JoelNymark/modu-hardware/PDFS/4x4pad/Back.png

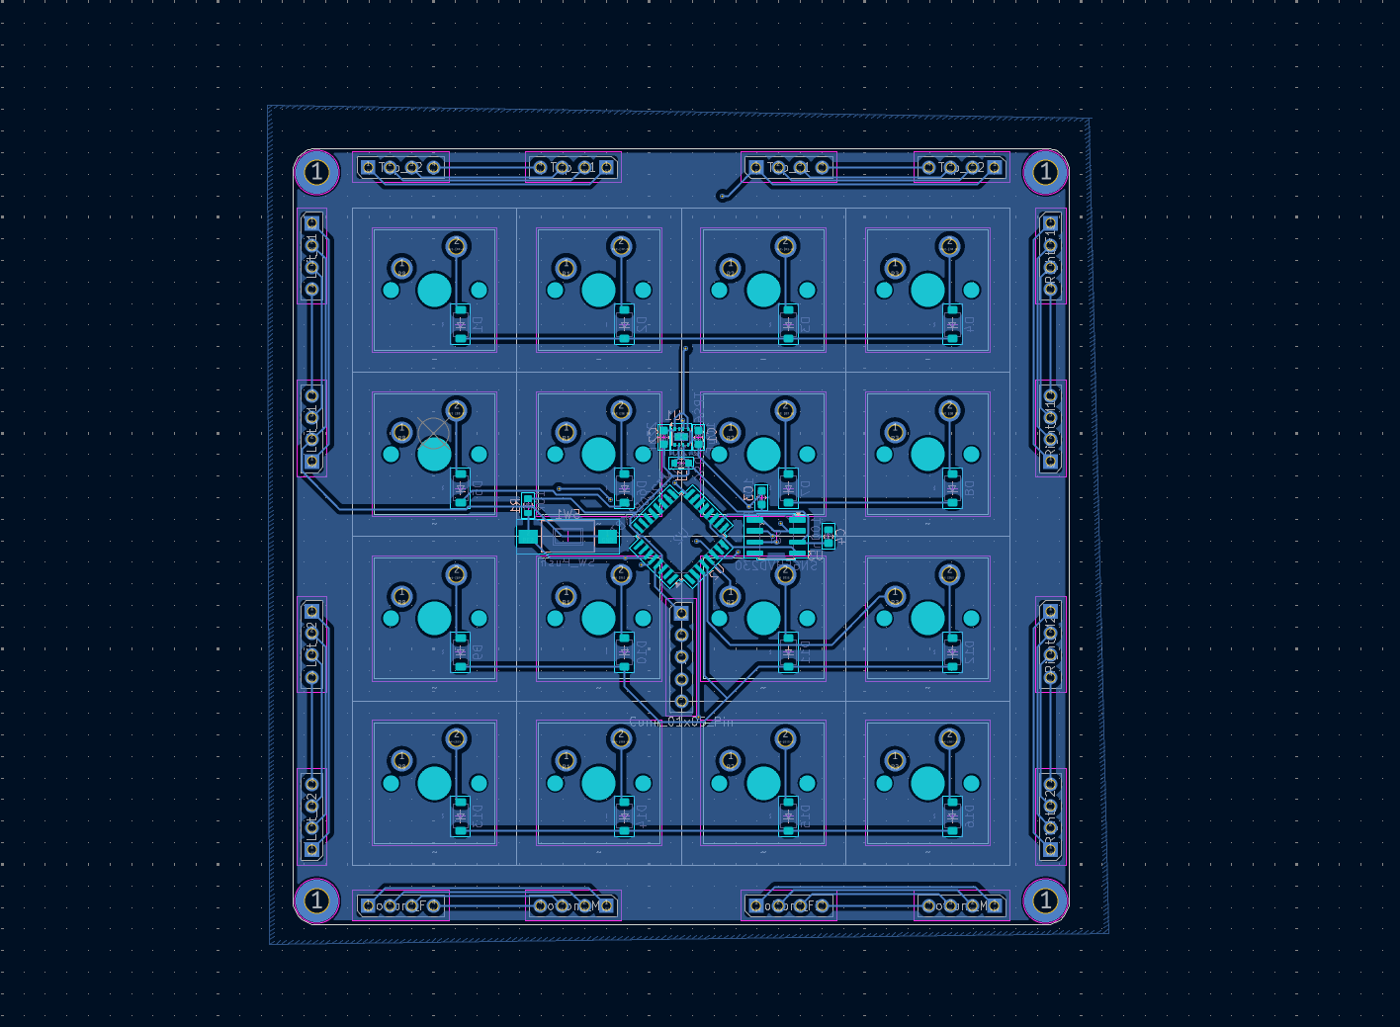
PDFS/4x4pad/Back.png
