JoelNymark/modu-hardware/PDFS/4x4pad/Front.png

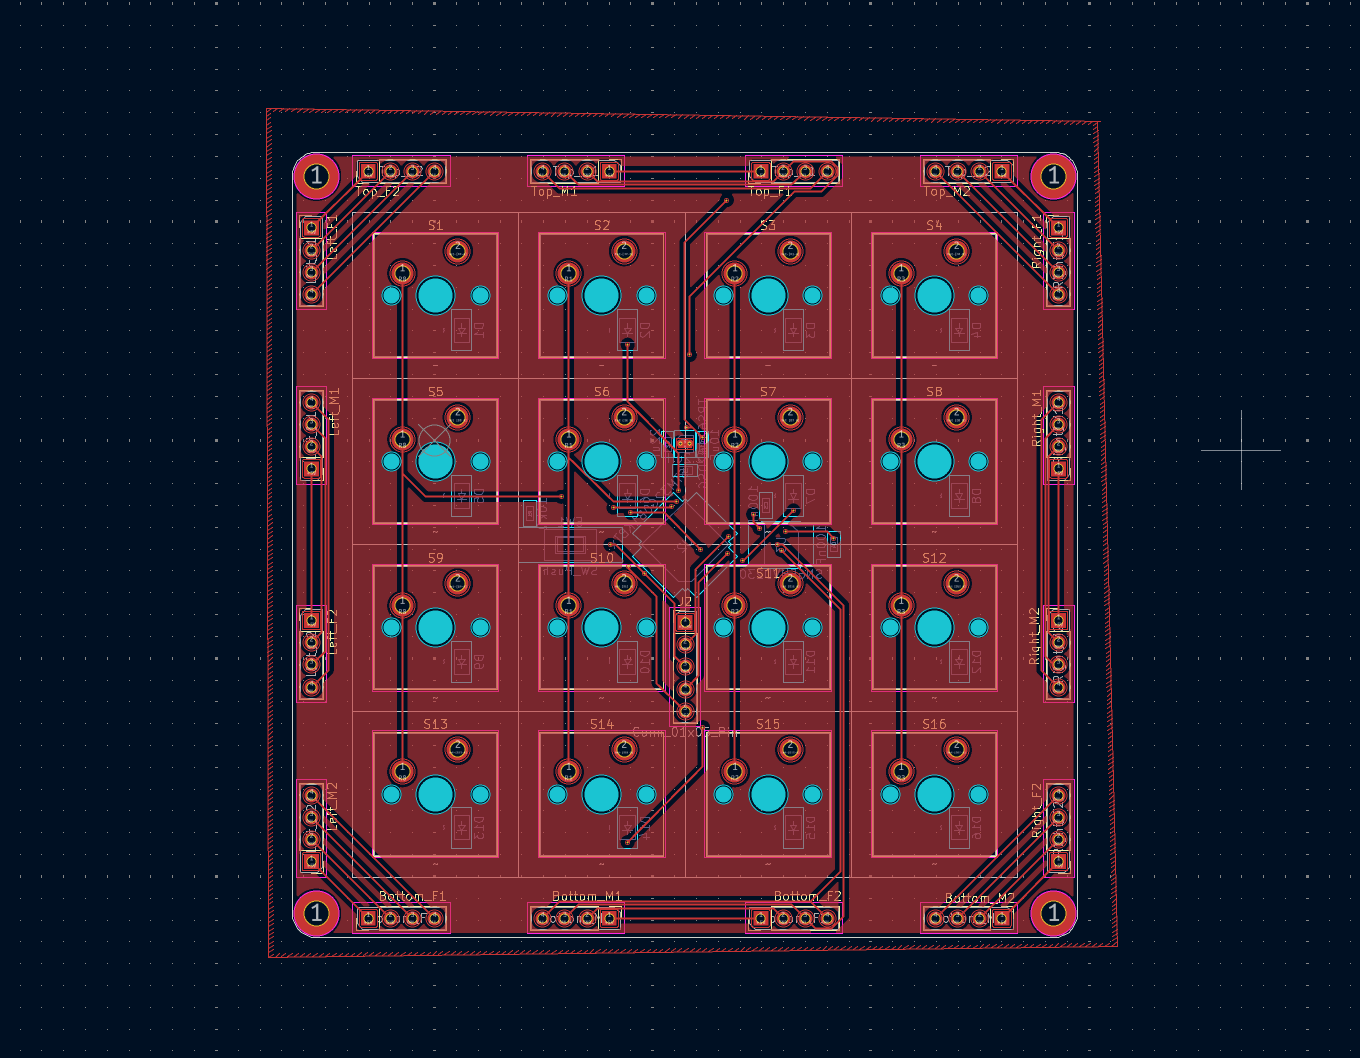
PDFS/4x4pad/Front.png
