JoelNymark/modu-hardware/PDFS/4x4pad/Screenshot 2026-10-29 231250.png

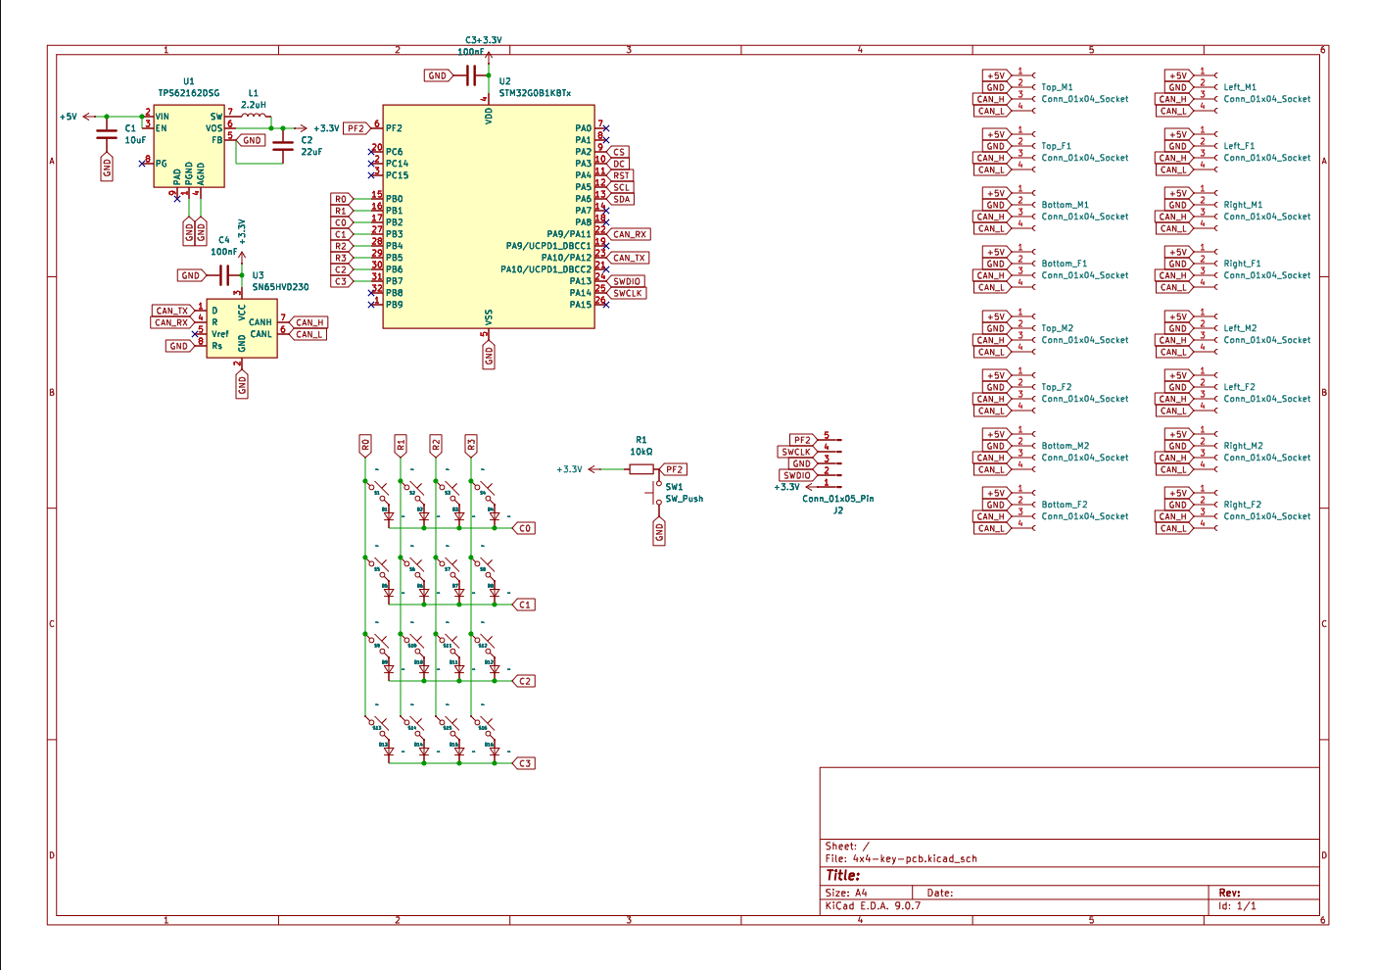
PDFS/4x4pad/Screenshot 2026-10-29 231250.png
