JoelNymark/modu-hardware/PDFS/Hub/Back.png

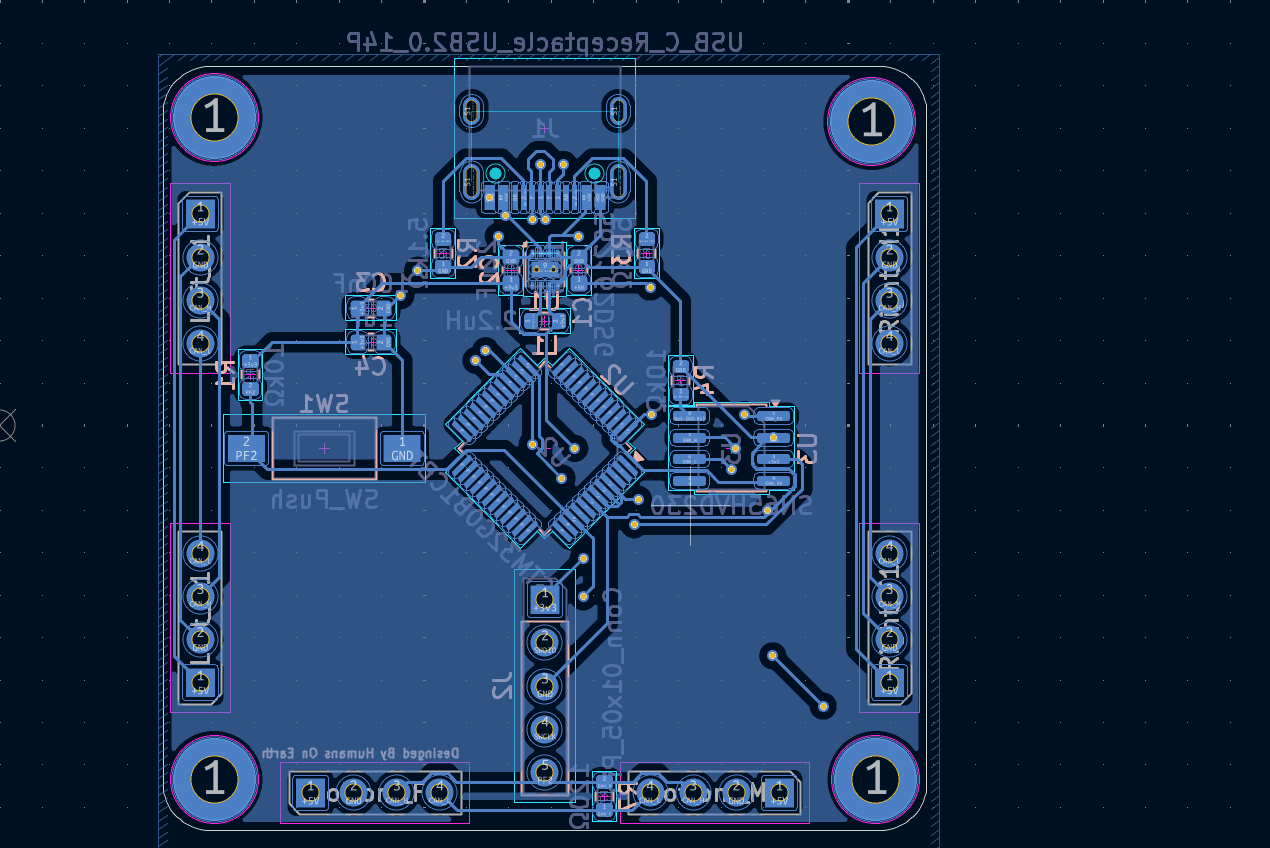
PDFS/Hub/Back.png
