JoelNymark/modu-hardware/PDFS/Hub/Front.png

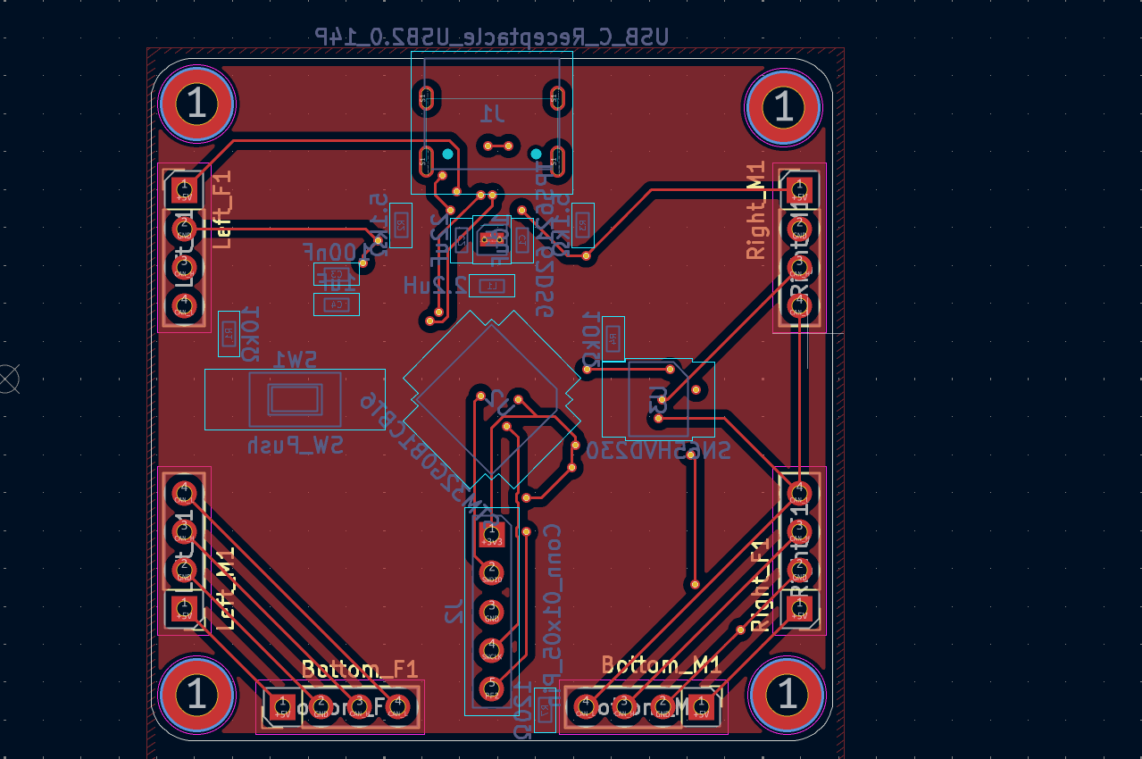
PDFS/Hub/Front.png
