JoelNymark/modu-hardware/PDFS/Hub/Screenshot 2026-10-29 224733.png

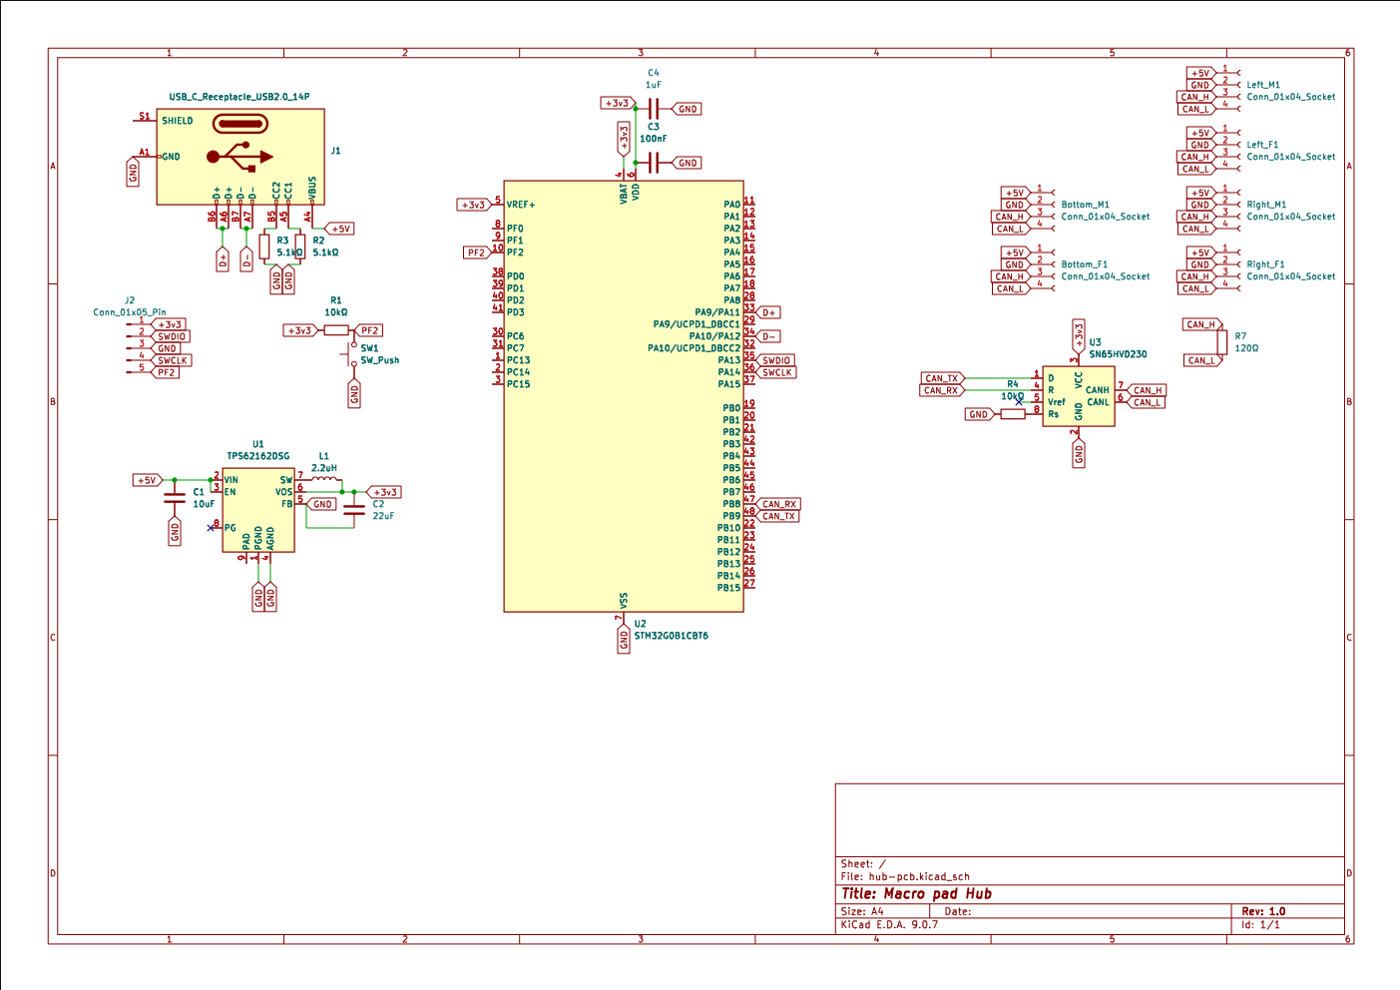
PDFS/Hub/Screenshot 2026-10-29 224733.png
