JoelNymark/modu-hardware/PDFS/Screen Module/Back.png

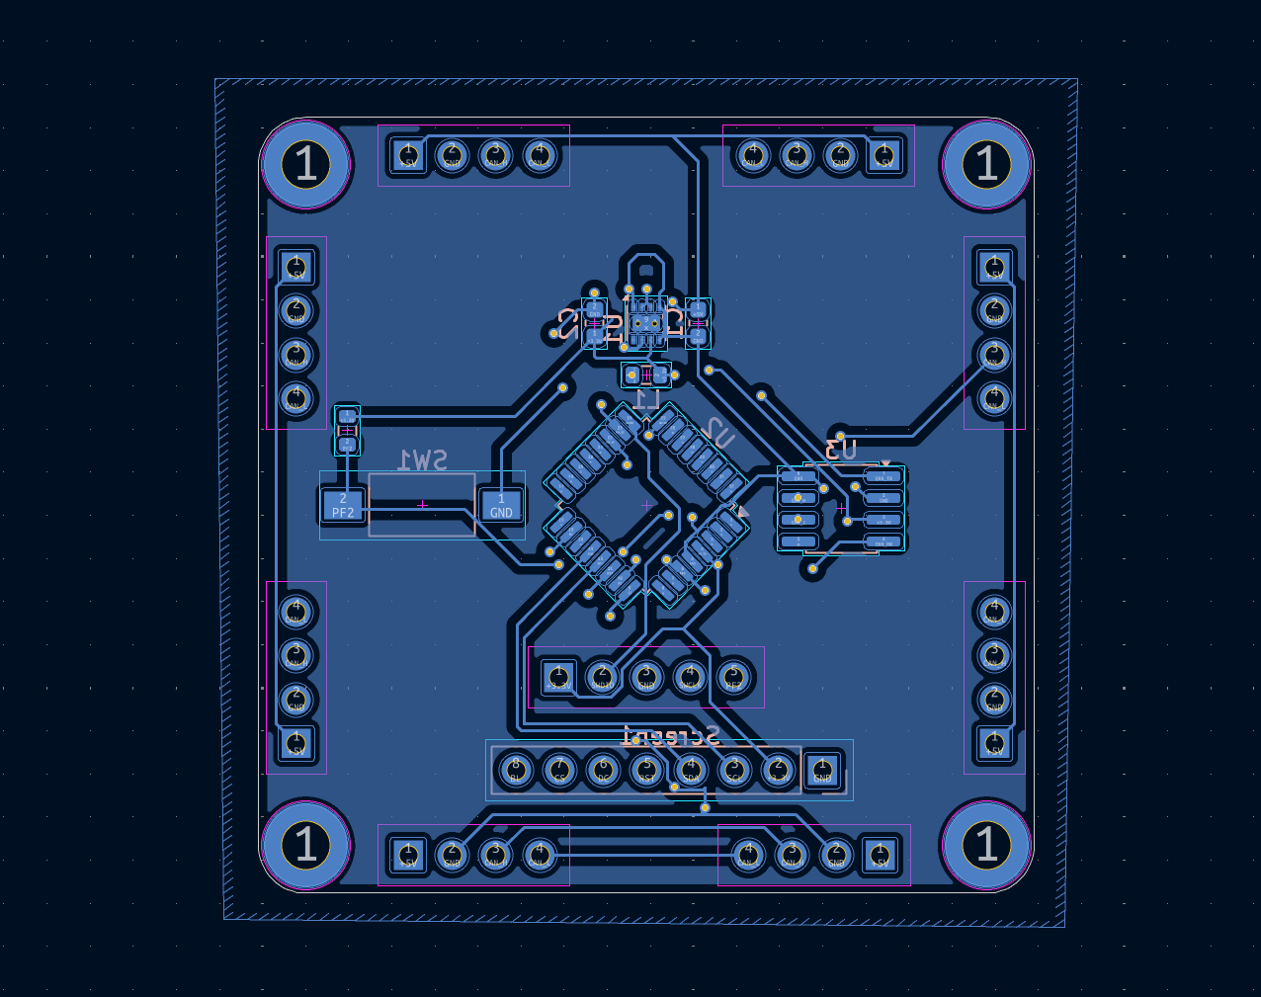
PDFS/Screen Module/Back.png
