JoelNymark/modu-hardware/PDFS/Screen Module/Front.png

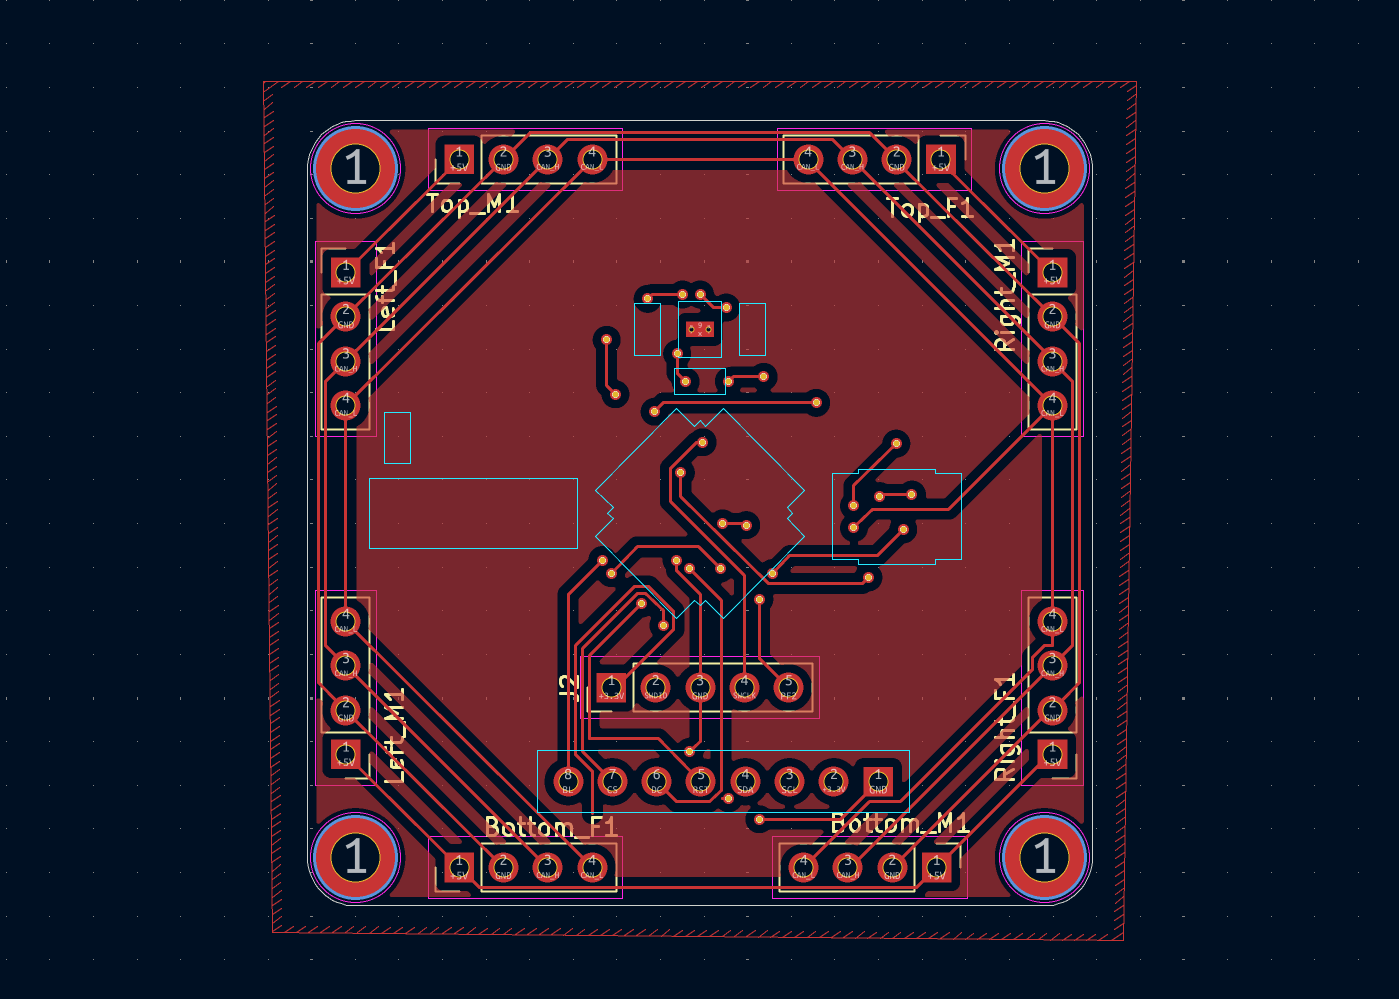
PDFS/Screen Module/Front.png
