JoelNymark/modu-hardware/PDFS/Screen Module/Screenshot 2026-10-29 230948.png

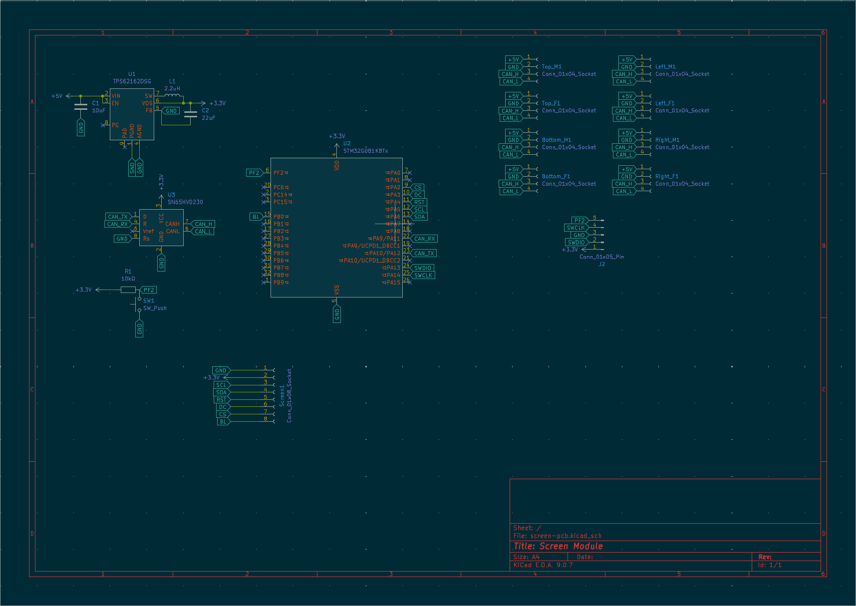
PDFS/Screen Module/Screenshot 2026-10-29 230948.png
