JoelNymark/modu-hardware/PDFS/Screen Module/Screenshot 2026-10-29 231049.png

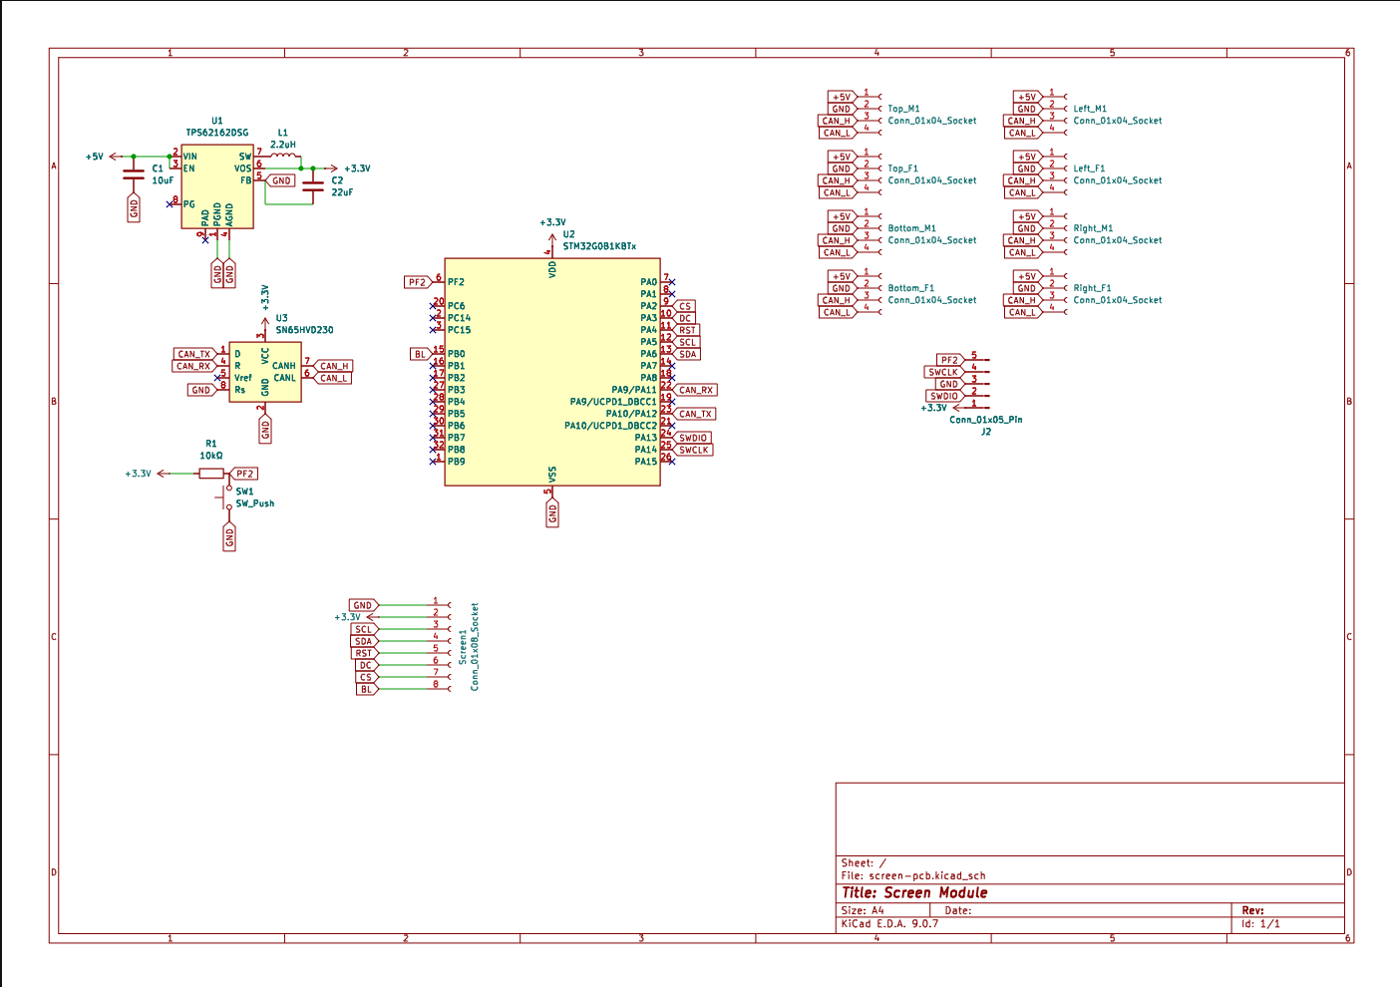
PDFS/Screen Module/Screenshot 2026-10-29 231049.png
