JoelNymark/modu-hardware/hub-pcb/production/bom.csv

Designator | Footprint | Quantity | Value | LCSC Part #
C1 | 0603 | 1 | 10uF
C2 | 0603 | 1 | 22uF
C3, C5, C6 | 0603 | 3 | 100nF
C4 | 0603 | 1 | 1uF
D1 | 2114 | 1 | D_Schottky
D2 | D_SOD-323 | 1 | D_Zener
D3, D4 | D_SOD-323 | 2 | D_TVS
J1 | USB_C_HRO_TYPE-C-31-M-12 | 1 | USB_C_Receptacle_USB2.0_14P
J2, J3, J4, J5, J6, J7 | PinHeader_1x04_P2.54mm_Vertical | 6 | Conn_01x04_Socket
J8 | PinHeader_1x05_P2.54mm_Vertical | 1 | Conn_01x05_Pin
J9 | PinHeader_1x08_P2.54mm_Vertical | 1 | Conn_01x08_Pin
L1 | 0603 | 1 | 2.2uH
R1, R4 | 0603 | 2 | 10kΩ
R2, R3 | 0603 | 2 | 5.1kΩ
R7 | 0603 | 1 | 120Ω
SW1 | SW_PUSH_1P1T_6x3.5mm_H4.3_APEM_MJTP1243 | 1 | SW_Push
U1 | WSON-8-1EP_2x2mm_P0.5mm_EP0.9x1.6mm_ThermalVias | 1 | TPS62162DSG
U2 | LQFP-48_7x7mm_P0.5mm | 1 | STM32G0B1CBT6
U3 | SOIC-8_3.9x4.9mm_P1.27mm | 1 | SN65HVD230
U4 | SOT-23-6 | 1 | USBLC6-2SC6
