JoelNymark/modu-hardware/4x4-key-pcb/production/bom.csv

Designator | Footprint | Quantity | Value | LCSC Part #
BOTTOM_F1, BOTTOM_F2, BOTTOM_M1, BOTTOM_M2, LEFT_F1, LEFT_F2, LEFT_M1, LEFT_M2, RIGHT_F1, RIGHT_F2, RIGHT_M1, RIGHT_M2, TOP_F1, TOP_F2, TOP_M1, TOP_M2 | PinHeader_1x04_P2.54mm_Vertical | 16 | Conn_01x04_Socket
C1 | 0603 | 1 | 10uF
C2 | 0603 | 1 | 22uF
C3, C4 | 0603 | 2 | 100nF
D1, D10, D11, D12, D13, D14, D15, D16, D2, D3, D4, D5, D6, D7, D8, D9 | Diode_SOD-123 | 16 | ~
J2 | PinHeader_1x05_P2.54mm_Vertical | 1 | Conn_01x05_Pin
L1 | 0603 | 1 | 2.2uH
R1 | 0603 | 1 | 10kΩ
S1, S10, S11, S12, S13, S14, S15, S16, S2, S3, S4, S5, S6, S7, S8, S9 | MX_PCB_1.00u | 16 | ~
SW1 | SW_SPST_FSMSM | 1 | SW_Push
U1 | WSON-8-1EP_2x2mm_P0.5mm_EP0.9x1.6mm_ThermalVias | 1 | TPS62162DSG
U2 | LQFP-32_7x7mm_P0.8mm | 1 | STM32G0B1KBTx
U3 | SOIC-8_3.9x4.9mm_P1.27mm | 1 | SN65HVD230
