JoelNymark/modu-hardware/hub-pcb/production/New folder/bom.csv

Designator | Footprint | Quantity | Value | LCSC Part #
BOTTOM_F1, BOTTOM_M1, LEFT_F1, LEFT_M1, RIGHT_F1, RIGHT_M1 | PinHeader_1x04_P2.54mm_Vertical | 6 | Conn_01x04_Socket
C1 | 0603 | 1 | 10uF
C2 | 0603 | 1 | 22uF
C3 | 0603 | 1 | 100nF
C4 | 0603 | 1 | 1uF
J1 | USB_C_HRO_TYPE-C-31-M-12 | 1 | USB_C_Receptacle_USB2.0_14P
J2 | PinHeader_1x05_P2.54mm_Vertical | 1 | Conn_01x05_Pin
L1 | 0603 | 1 | 2.2uH
R1, R4 | 0603 | 2 | 10kΩ
R2, R3 | 0603 | 2 | 5.1kΩ
R7 | 0603 | 1 | 120Ω
SW1 | SW_SPST_FSMSM | 1 | SW_Push
U1 | WSON-8-1EP_2x2mm_P0.5mm_EP0.9x1.6mm_ThermalVias | 1 | TPS62162DSG
U2 | LQFP-48_7x7mm_P0.5mm | 1 | STM32G0B1CBT6
U3 | SOIC-8_3.9x4.9mm_P1.27mm | 1 | SN65HVD230
