JoelNymark/modu-hardware/4x4-key-pcb/4x4-key-pcb.stl

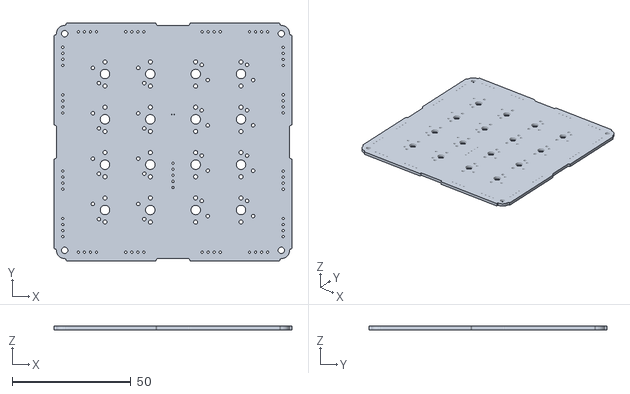
[picture p16: CAD file, 2026-11-02]
4x4-key-pcb/4x4-key-pcb.stl
100.0 x 100.0 x 1.51
