JoelNymark/modu-hardware/hub-pcb/hub-pcb.step

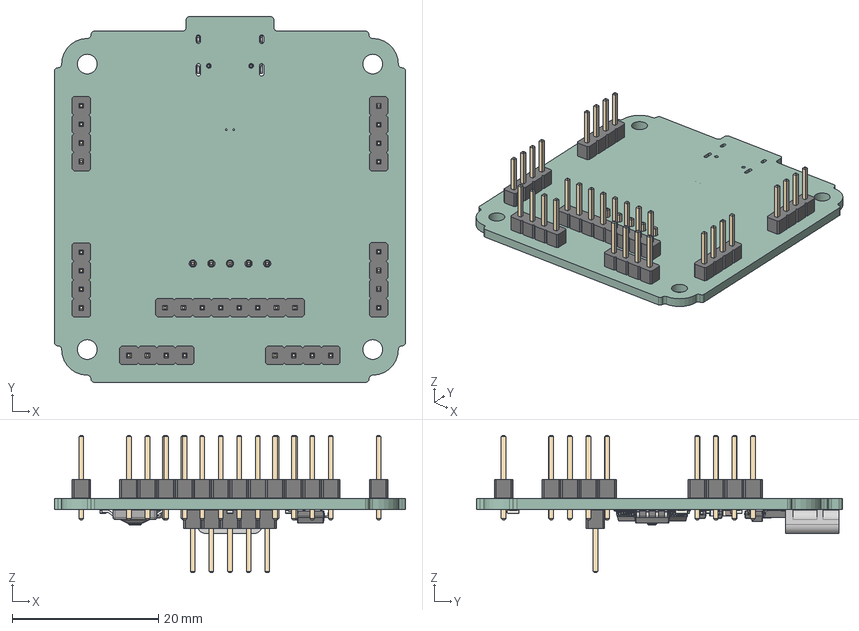
[picture p17: CAD file, 2026-11-02]
hub-pcb/hub-pcb.step
48.0 x 50.0 x 18.8 mm
PinHeader_1x04_P254mm_Vertical x 6
PinHeader_1x08_P254mm_Vertical
D_2114
C_0603_1608Metric x 6
SOIC-8_3.9x4.9mm_P1.27mm
R_0603_1608Metric x 6
WSON_8_1EP_2x2mm_P05mm_EP09x16mm
D_SOD-323 x 3
SOT-23-6
LQFP-48_7x7mm_P0.5mm
pines
cuerpo
boton
PinHeader_1x05_P254mm_Vertical
HRO TYPE-C-31-M-12 v4
hub330C_PCB
