JoelNymark/modu-hardware/hub-pcb/hub-pcb-nocomps.stl

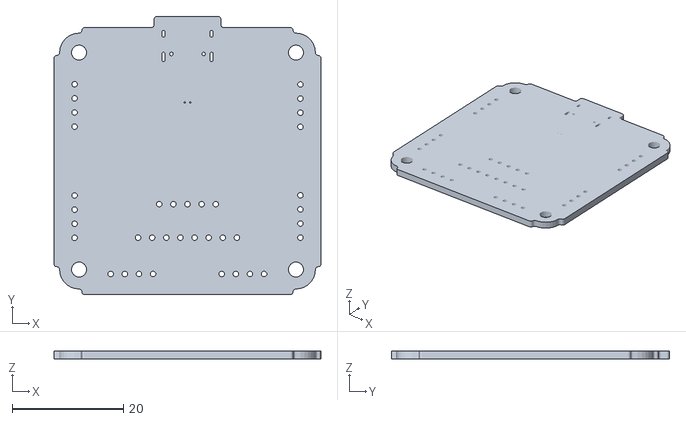
[picture p18: CAD file, 2026-11-02]
hub-pcb/hub-pcb-nocomps.stl
48.0 x 50.0 x 1.51
