JoelNymark/modu-hardware/(list of files, cad)

Other CAD files:
hub-pcb/hub-pcb.stl
