JoelNymark/modu-hardware/hub-pcb/plots/hub-pcb__Assembly.pdf

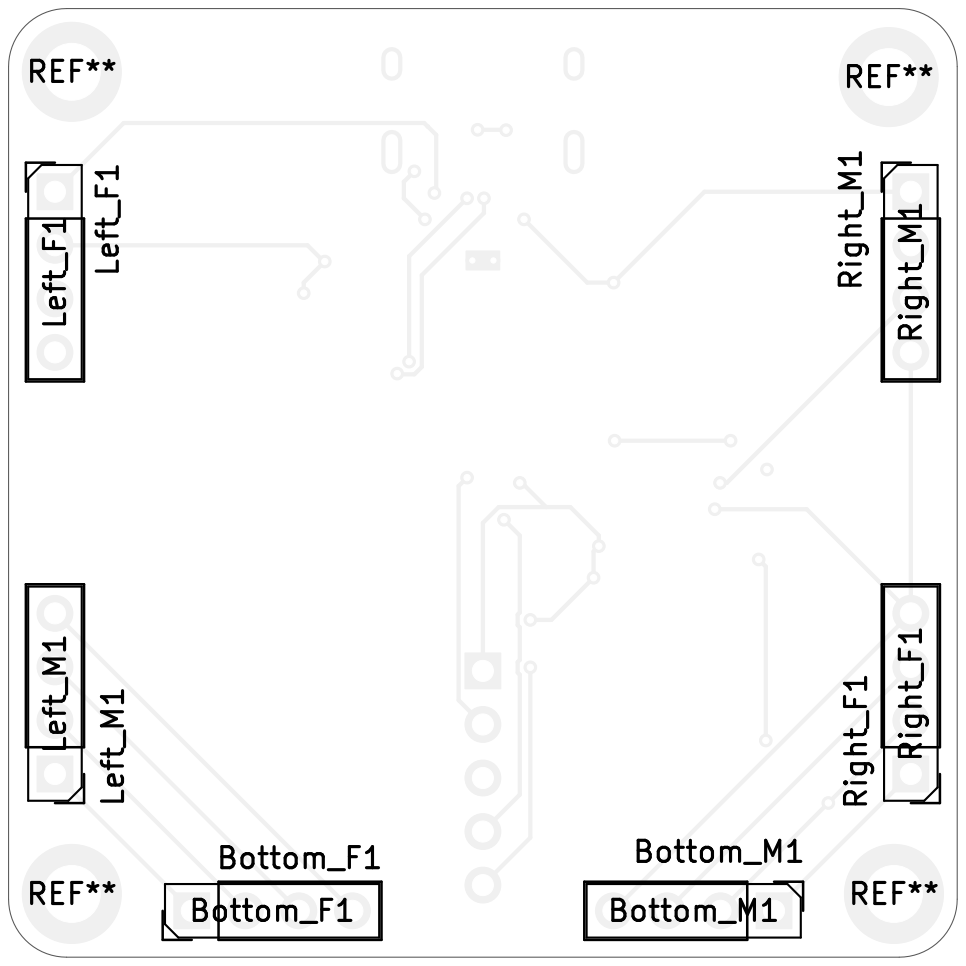
[picture p19: page 1]
Left_M1 Bottom_M1 Left_F1 Bottom_F1 Right_M1 Right_F1 1 2 3 4 5 6; D Date: KiCad; E.D.A. 9.0.7 Size: A4; Rev:; Id: /1 Title: File: hub-pcb.kicad_pcb Sheet: Black; And; White; TOP; Board2Pdf:; Black; TOP -; Page; REF** REF** Left_M¹ REF**; REF** Bottom_M1 Left_F1; Bottom_F1; Right_M¹ Right_F1

C3 Conn_01x05_Pin | J2 þÿ120© R7 | þÿ5.1k© R2

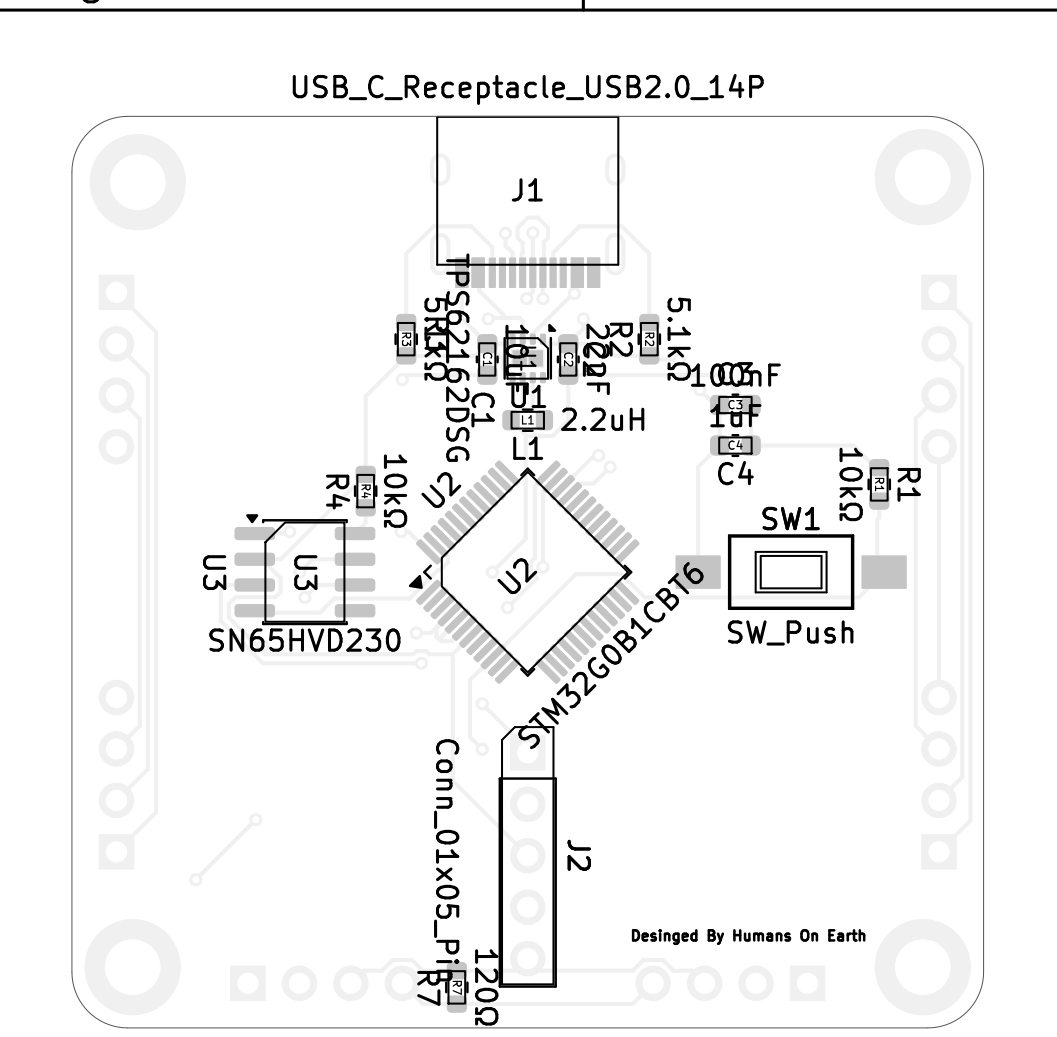
[picture p20: page 2]
