JoelNymark/modu-hardware/PDFS/4x4pad/4x4-key-pcb.pdf

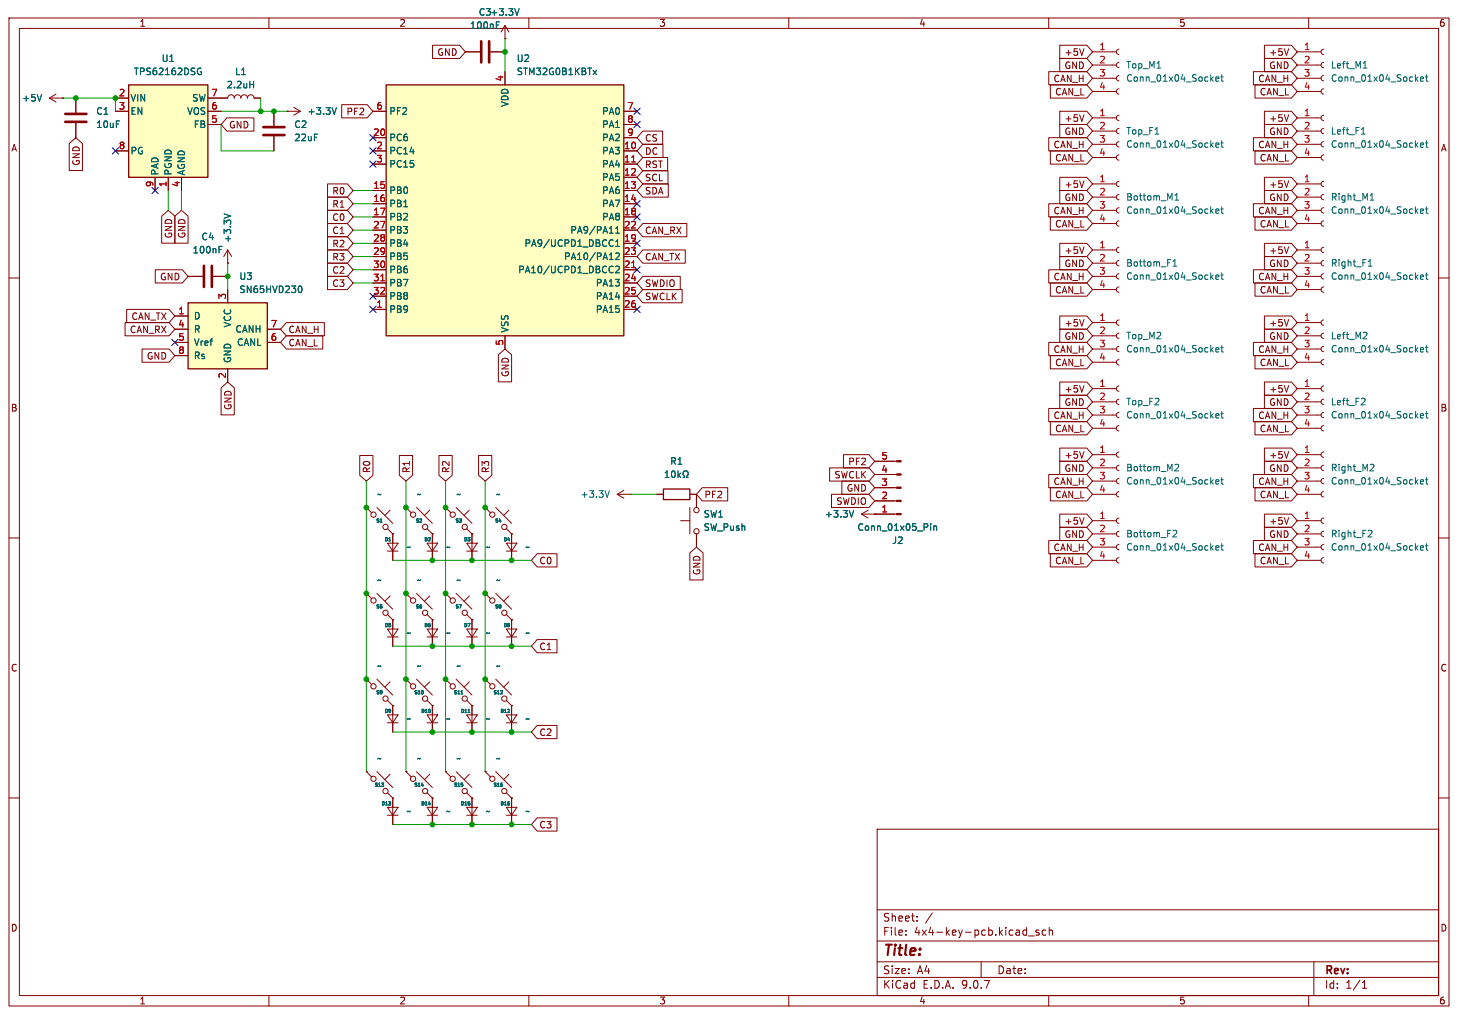
[picture p21: page 1]

Id: 1/1 Title: File: 4x4-key-pcb.kicad_sch Sheet: /
