JoelNymark/modu-hardware/PDFS/Hub/hub-pcb.pdf

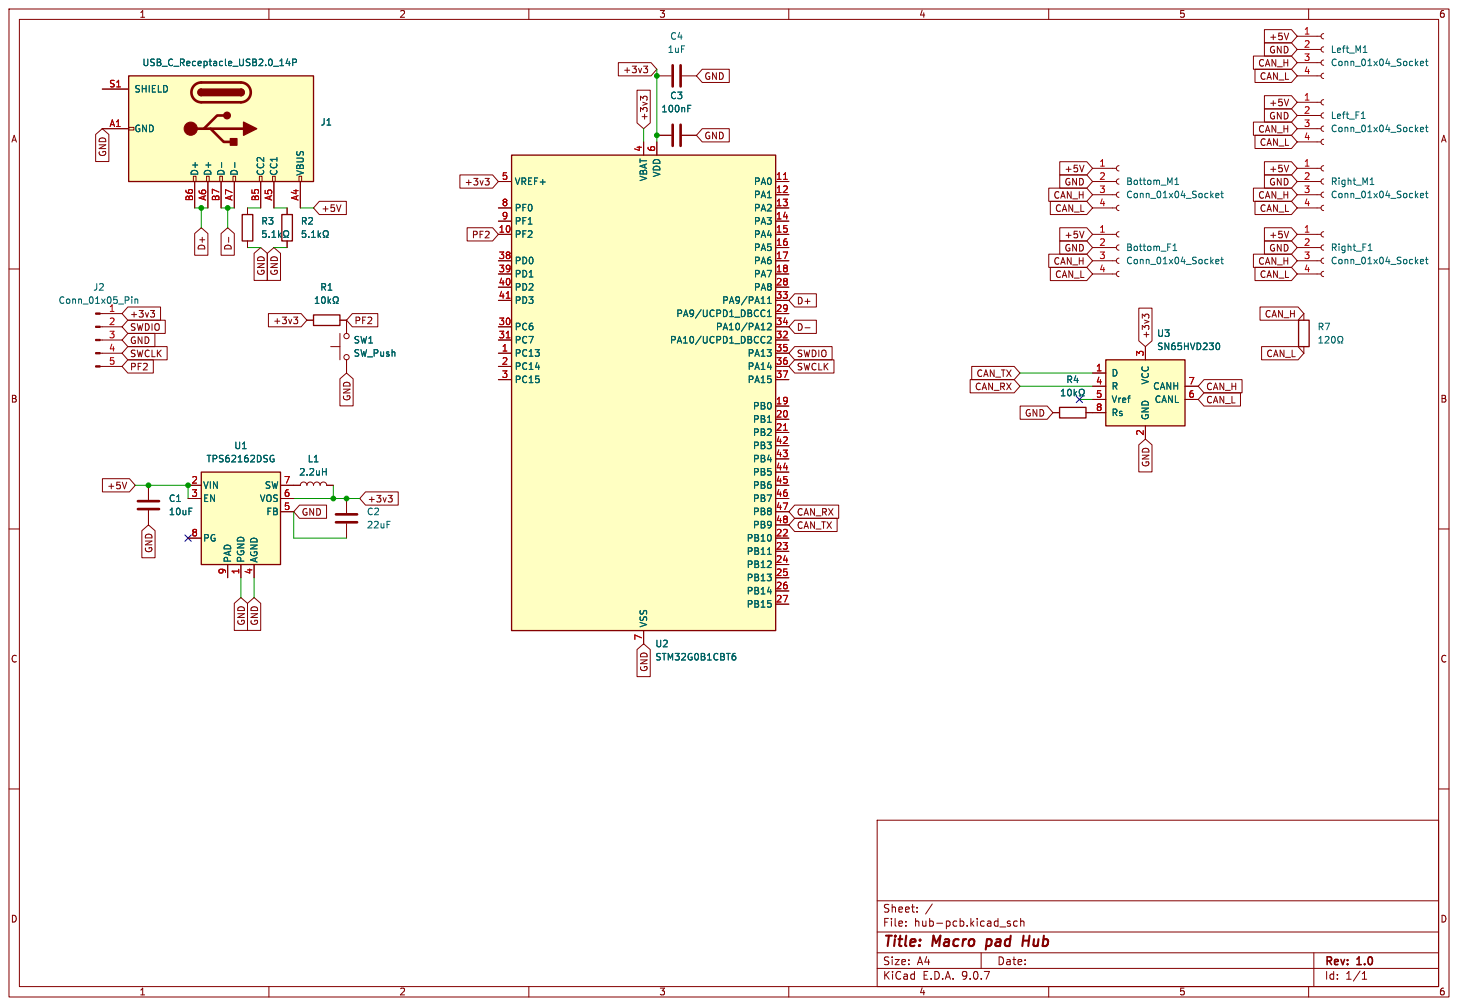
[picture p22: page 1]

GND GND GND GND GND

File: hub-pcb.kicad_sch Sheet: /
Id: 1/1 Title: Macro pad Hub
