JoelNymark/modu-hardware/PDFS/Screen Module/screen-pcb.pdf

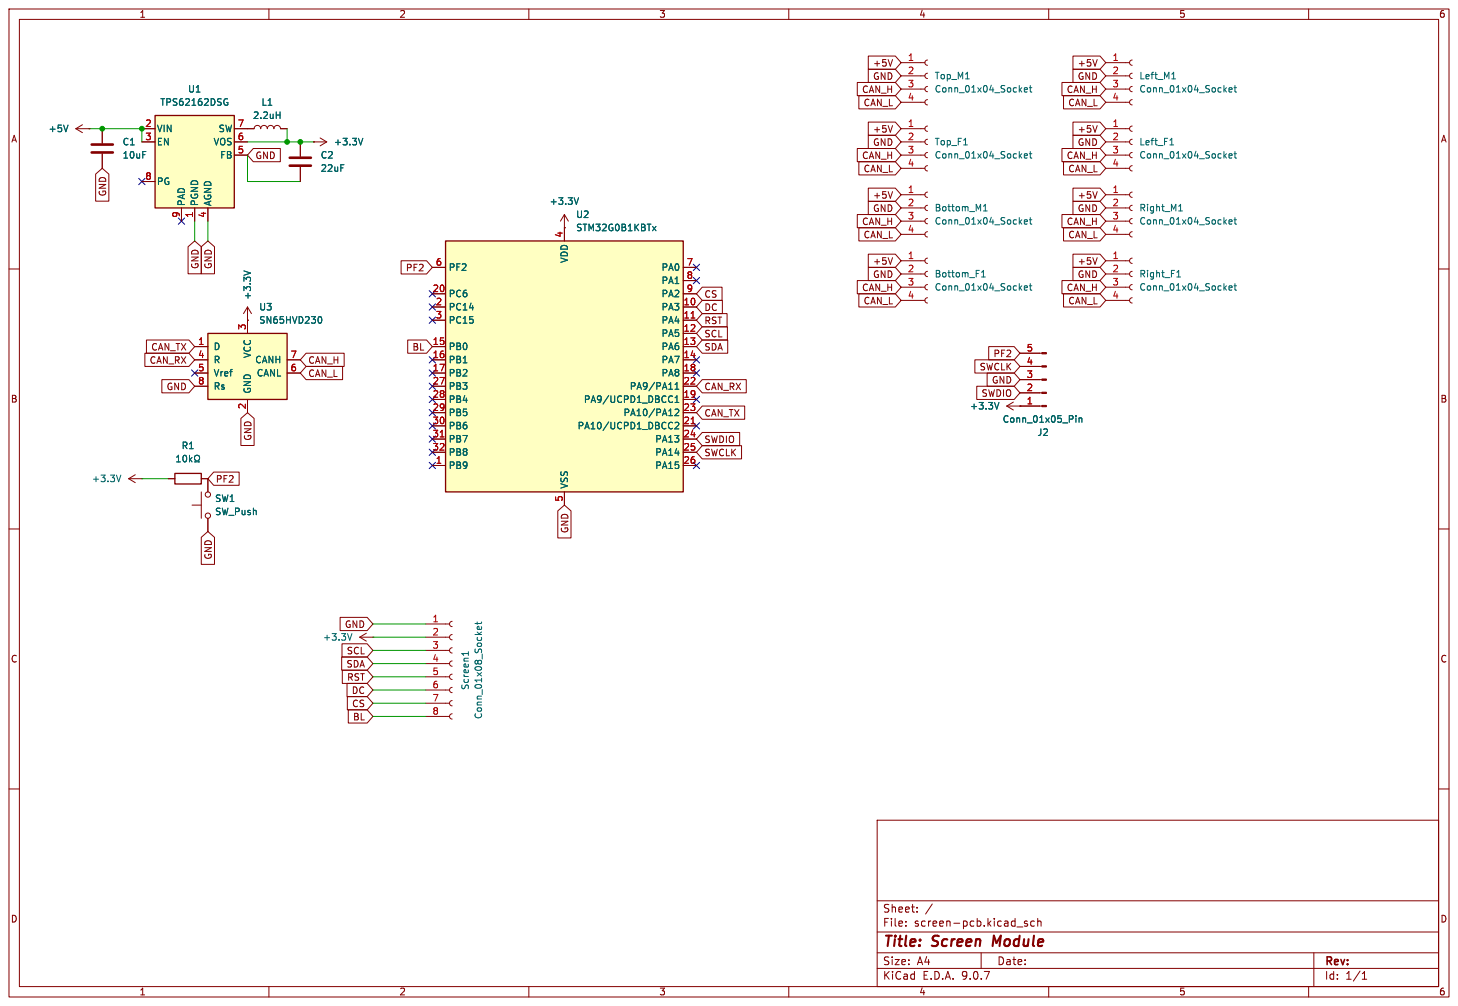
[picture p23: page 1]

SCL SDA RST GND

Id: 1/1 Title: Screen Module
