JoelNymark/modu-hardware/hub-pcb/PDFS/Hub/hub-pcb.pdf

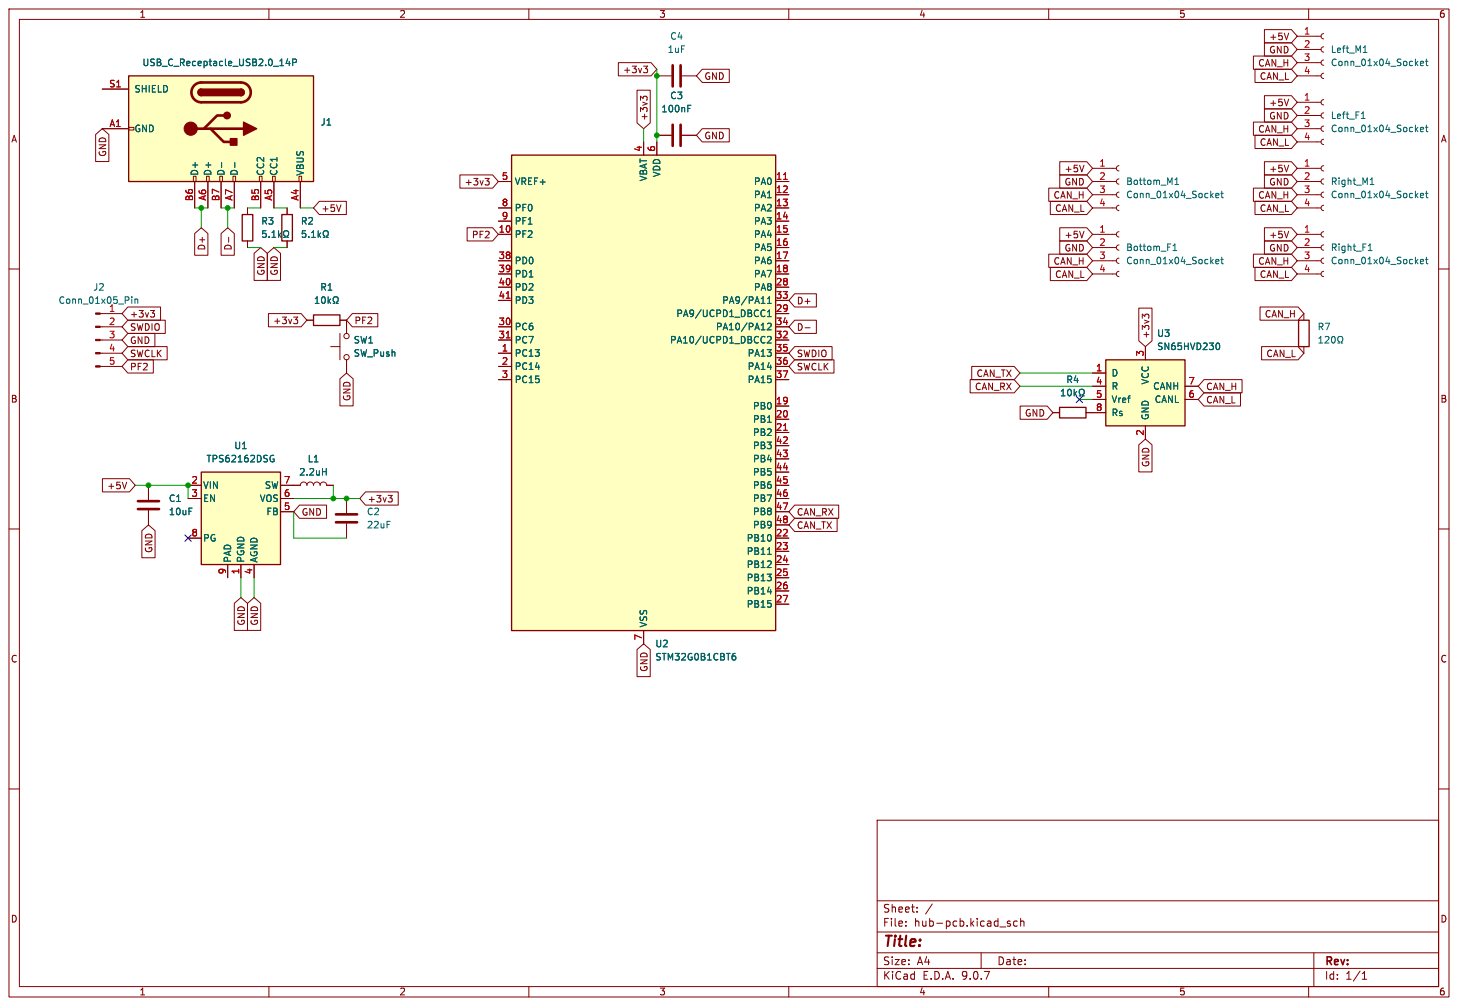
[picture p24: page 1]

GND GND GND GND GND

Id: 1/1 Title: File: hub-pcb.kicad_sch Sheet: /
