JoelNymark/modu-hardware/4x4-key-pcb/4x4-key-pcb.kicad_pcb

## KiCad design 4x4-key-pcb/4x4-key-pcb.kicad_pcb (2026-11-10)

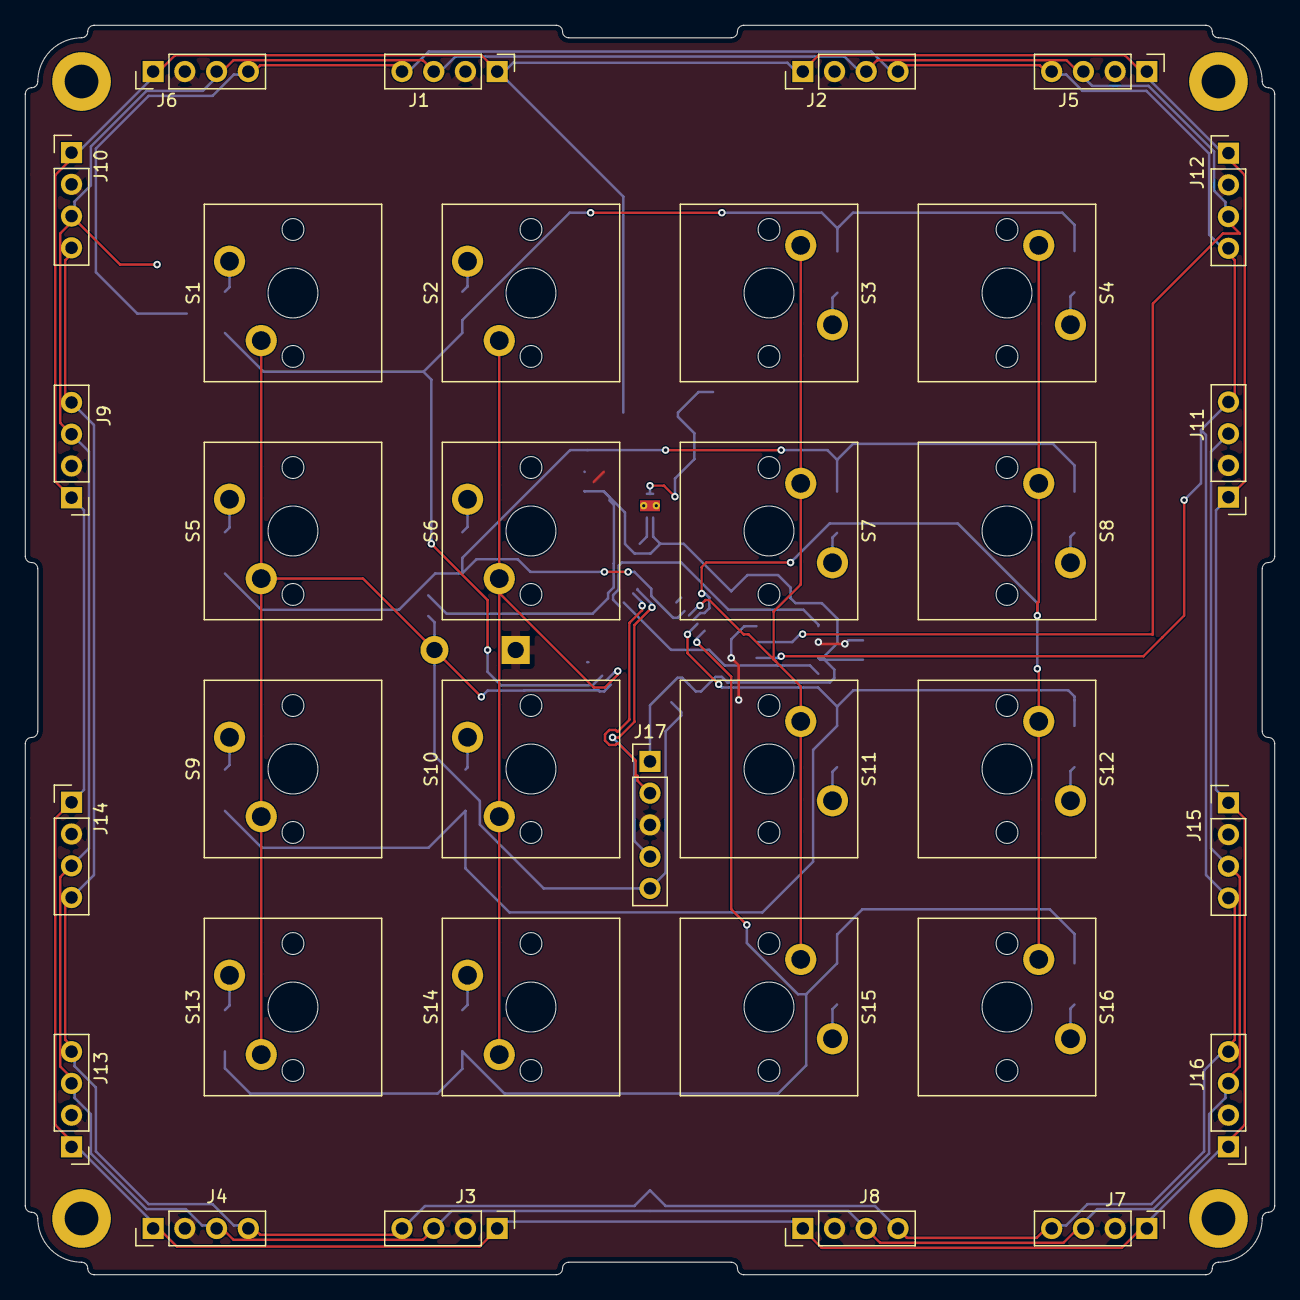
[picture p25: board 4x4-key-pcb.kicad_pcb from above]

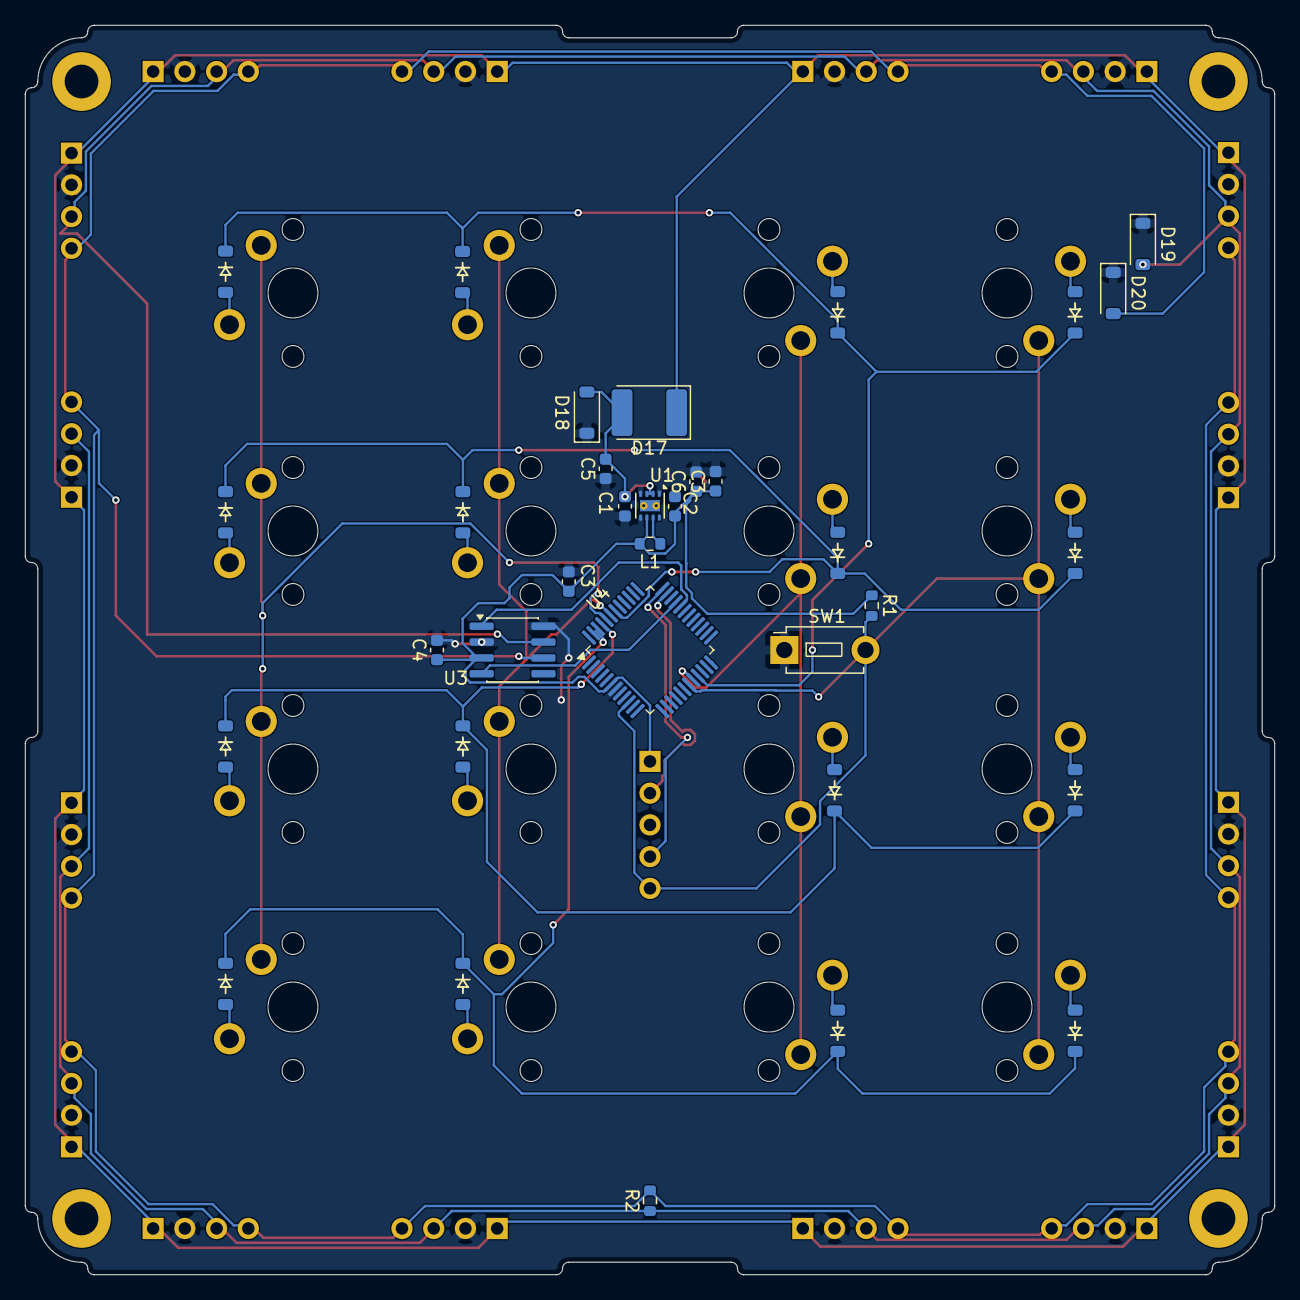
[picture p26: board 4x4-key-pcb.kicad_pcb from below]

Board: 2 copper layers, 100.0 x 100.0 mm, 67 parts (34 on the bottom side), 36 nets.

Parts:
C1: 10uF; C_0603_1608Metric
C2: 22uF; C_0603_1608Metric
C3, C3#2, C4, C5, C6: 100nF; C_0603_1608Metric
D1, D2, D3, D4, D5, D6, D7, D8, D9, D10, D11, D12, D13, D14, D15, D16: Diode_SOD-123
D17: D_Schottky; D_2114_3652Metric
D18, D19, D20: D_TVS; D_SOD-123
J1, J2, J3, J4, J5, J6, J7, J8, J9, J10, J11, J12, J13, J14, J15, J16: Conn_01x04_Socket; PinHeader_1x04_P2.54mm_Vertical
J17: Conn_01x05_Pin; PinHeader_1x05_P2.54mm_Vertical
L1: 2.2uH; R_0603_1608Metric
R1: 10kΩ; R_0603_1608Metric
R2: R120Ω; R_0603_1608Metric
S1, S2, S3, S4, S5, S6, S7, S8, S9, S10, S11, S12, S13, S14, S15, S16: MX_PCB_1.00u
SW1: SW_Push; SW_PUSH_1P1T_6x3.5mm_H4.3_APEM_MJTP1243
U1: TPS62162DSG; WSON-8-1EP_2x2mm_P0.5mm_EP0.9x1.6mm_ThermalVias
U3: SN65HVD230; SOIC-8_3.9x4.9mm_P1.27mm
U4: STM32G0B1CBTx; LQFP-48_7x7mm_P0.5mm

Connections:
+3.3V: C2.1, C3.1, C3#2.1, C4.1, C6.1, J17.1, L1.2, R1.1, U1.6 (VOS), U3.3 (VCC), U4.6 (VDD)
+5V: D17.1 (K), J1.1, J2.1, J3.1, J4.1, J5.1, J6.1, J7.1, J8.1, J9.1, J10.1, J11.1, J12.1, J13.1, J14.1, J15.1, J16.1
C0: D1.1 (K), D2.1 (K), D3.1 (K), D4.1 (K), U4.21 (PB2)
C1: D5.1 (K), D6.1 (K), D7.1 (K), D8.1 (K), U4.42 (PB3)
C2: D9.1 (K), D10.1 (K), D11.1 (K), D12.1 (K), U4.45 (PB6)
C3: D13.1 (K), D14.1 (K), D15.1 (K), D16.1 (K), U4.46 (PB7)
CAN_H: D19.2 (A2), J1.3, J2.3, J3.3, J4.3, J5.3, J6.3, J7.3, J8.3, J9.3, J10.3, J11.3, J12.3, J13.3, J14.3, J15.3, J16.3, R2.1, U3.7 (CANH)
CAN_L: D20.2 (A2), J1.4, J2.4, J3.4, J4.4, J5.4, J6.4, J7.4, J8.4, J9.4, J10.4, J11.4, J12.4, J13.4, J14.4, J15.4, J16.4, R2.2, U3.6 (CANL)
CAN_RX: U3.4 (R), U4.33 (PA9/PA11)
CAN_TX: U3.1 (D), U4.32 (PA10/UCPD1_DBCC2)
GND: C1.2, C2.2, C3.2, C3#2.2, C4.2, C5.1, C6.2, D18.1 (A1), D19.1 (A1), D20.1 (A1), J1.2, J2.2, J3.2, J4.2, J5.2, J6.2, J7.2, J8.2, J9.2, J10.2, J11.2, J12.2, J13.2, J14.2, J15.2, J16.2, J17.3, SW1.1, U1.1 (PGND), U1.4 (AGND), U1.5 (FB), U3.2 (GND), U3.8 (Rs), U4.7 (VSS)
unnamed: D1.2 (A), S1.2
unnamed: D2.2 (A), S2.2
unnamed: D3.2 (A), S3.2
unnamed: D4.2 (A), S4.2
unnamed: D5.2 (A), S5.2
unnamed: D6.2 (A), S6.2
unnamed: D7.2 (A), S7.2
unnamed: D8.2 (A), S8.2
unnamed: D9.2 (A), S9.2
unnamed: D10.2 (A), S10.2
unnamed: D11.2 (A), S11.2
unnamed: D12.2 (A), S12.2
unnamed: D13.2 (A), S13.2
unnamed: D14.2 (A), S14.2
unnamed: D15.2 (A), S15.2
unnamed: D16.2 (A), S16.2
unnamed: C1.1, C5.2, D17.2 (A), D18.2 (A2), U1.2 (VIN), U1.3 (EN)
unnamed: L1.1, U1.7 (SW)
PF2: J17.5, R1.2, SW1.2, U4.10 (PF2)
R0: S1.1, S5.1, S9.1, S13.1, U4.19 (PB0)
R1: S2.1, S6.1, S10.1, S14.1, U4.20 (PB1)
R2: S3.1, S7.1, S11.1, S15.1, U4.43 (PB4)
R3: S4.1, S8.1, S12.1, S16.1, U4.44 (PB5)
SWCLK: J17.4, U4.36 (PA14)
SWDIO: J17.2, U4.35 (PA13)
