JoelNymark/modu-hardware/hub-pcb/hub-pcb.kicad_pcb

## KiCad design hub-pcb/hub-pcb.kicad_pcb (2026-11-10)

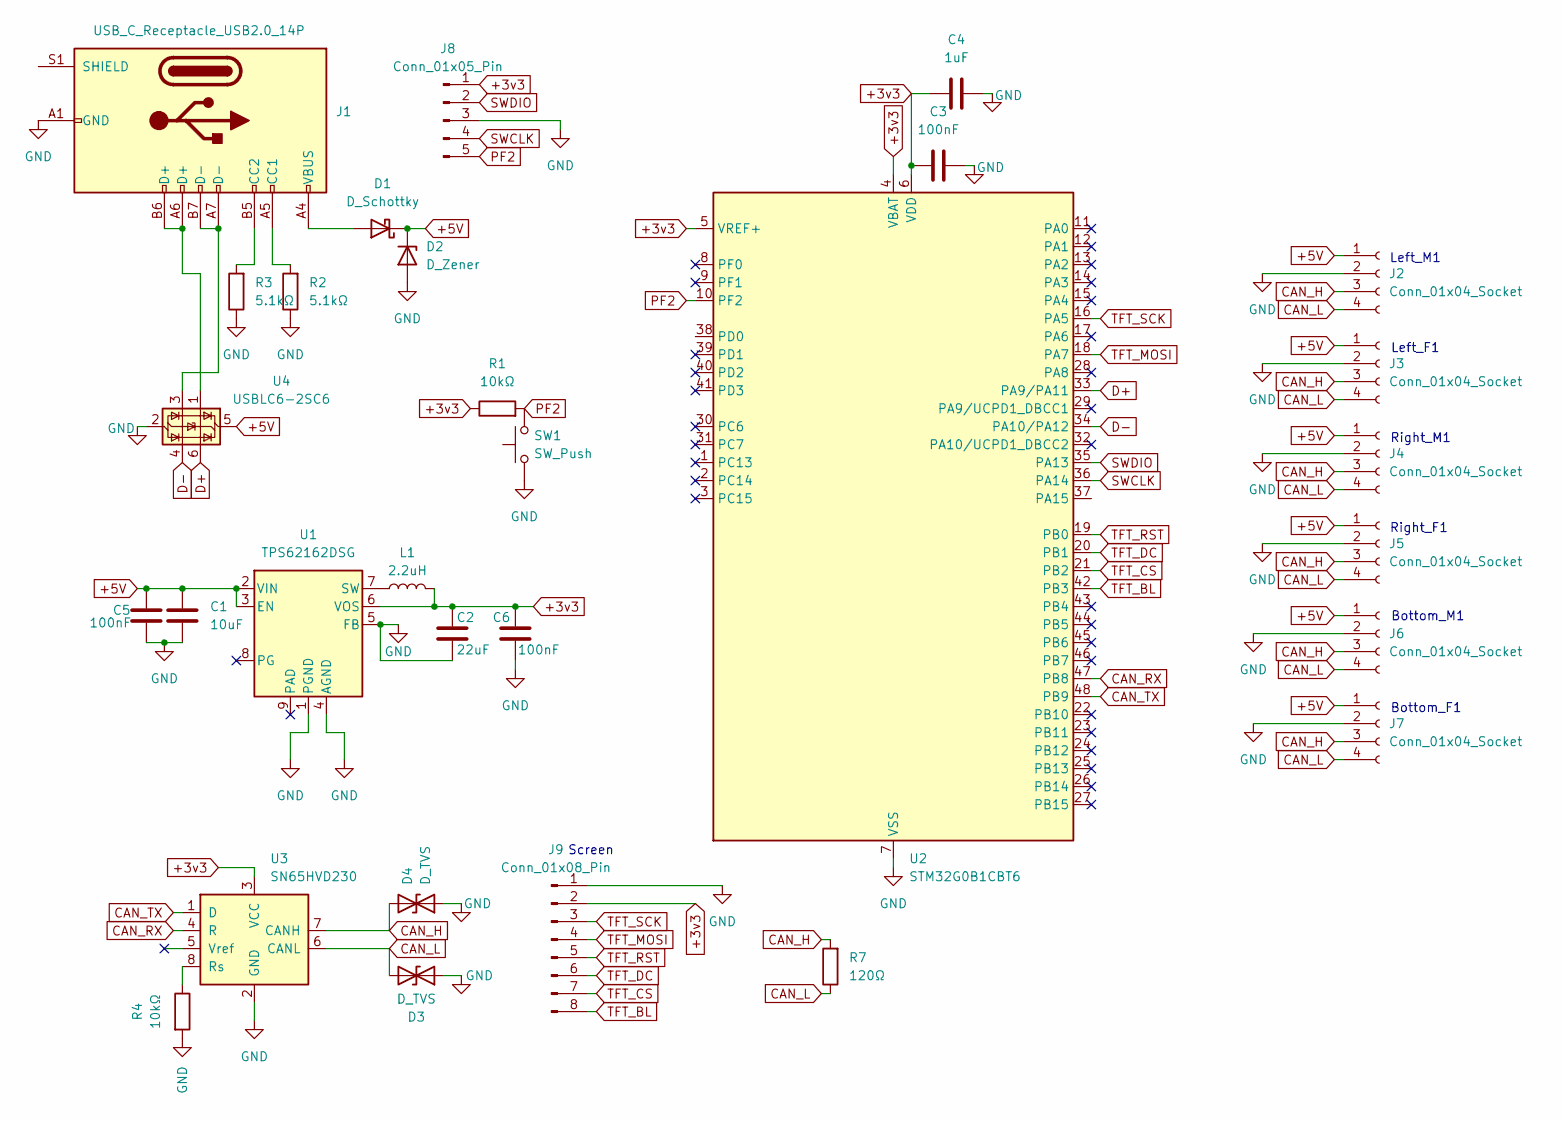
[picture p27: schematic hub-pcb.kicad_sch, Macro pad Hub]

Parts:
C1: 10uF; C_0603_1608Metric
C2: 22uF; C_0603_1608Metric
C3, C5, C6: 100nF; C_0603_1608Metric
C4: 1uF; C_0603_1608Metric
D1: D_Schottky; D_2114_3652Metric
D2: D_Zener; D_SOD-323
D3, D4: D_TVS; D_SOD-323
J1: USB_C_Receptacle_USB2.0_14P; USB_C_HRO_TYPE-C-31-M-12
J2, J3, J4, J5, J6, J7: Conn_01x04_Socket; PinHeader_1x04_P2.54mm_Vertical
J8: Conn_01x05_Pin; PinHeader_1x05_P2.54mm_Vertical
J9: Conn_01x08_Pin; PinHeader_1x08_P2.54mm_Vertical
L1: 2.2uH; R_0603_1608Metric
R1, R4: 10kΩ; R_0603_1608Metric
R2, R3: 5.1kΩ; R_0603_1608Metric
R7: 120Ω; R_0603_1608Metric
SW1: SW_Push; SW_PUSH_1P1T_6x3.5mm_H4.3_APEM_MJTP1243
U1: TPS62162DSG; WSON-8-1EP_2x2mm_P0.5mm_EP0.9x1.6mm_ThermalVias
U2: STM32G0B1CBT6; LQFP-48_7x7mm_P0.5mm
U3: SN65HVD230; SOIC-8_3.9x4.9mm_P1.27mm
U4: USBLC6-2SC6; SOT-23-6

Connections:
+3v3: C2.1, C3.1, C4.1, C6.1, J8.1, J9.2, L1.2, R1.1, U1.6 (VOS), U2.4 (VBAT), U2.5 (VREF+), U2.6 (VDD), U3.3 (VCC)
+5V: C1.1, C5.1, D1.1 (K), D2.1 (K), J2.1, J3.1, J4.1, J5.1, J6.1, J7.1, U1.2 (VIN), U1.3 (EN), U4.5 (VBUS)
CAN_H: D4.2 (A2), J2.3, J3.3, J4.3, J5.3, J6.3, J7.3, R7.2, U3.7 (CANH)
CAN_L: D3.2 (A2), J2.4, J3.4, J4.4, J5.4, J6.4, J7.4, R7.1, U3.6 (CANL)
CAN_RX: U2.47 (PB8), U3.4 (R)
CAN_TX: U2.48 (PB9), U3.1 (D)
D+: U2.33 (PA9/PA11), U4.6 (I/O1)
D-: U2.34 (PA10/PA12), U4.4 (I/O2)
GND: C1.2, C2.2, C3.2, C4.2, C5.2, C6.2, D2.2 (A), D3.1 (A1), D4.1 (A1), J1.A1 (GND), J1.A12 (GND), J1.B1 (GND), J1.B12 (GND), J2.2, J3.2, J4.2, J5.2, J6.2, J7.2, J8.3, J9.1, R2.1, R3.1, R4.2, SW1.1, U1.1 (PGND), U1.4 (AGND), U1.5 (FB), U2.7 (VSS), U3.2 (GND), U4.2 (GND)
unnamed: D1.2 (A), J1.A4 (VBUS), J1.A9 (VBUS), J1.B4 (VBUS), J1.B9 (VBUS)
unnamed: J1.A5 (CC1), R2.2
unnamed: J1.B5 (CC2), R3.2
unnamed: J1.A6 (D+), J1.B6 (D+), U4.1 (I/O1)
unnamed: J1.A7 (D-), J1.B7 (D-), U4.3 (I/O2)
unnamed: L1.1, U1.7 (SW)
unnamed: R4.1, U3.8 (Rs)
PF2: J8.5, R1.2, SW1.2, U2.10 (PF2)
SWCLK: J8.4, U2.36 (PA14)
SWDIO: J8.2, U2.35 (PA13)
TFT_BL: J9.8, U2.42 (PB3)
TFT_CS: J9.7, U2.21 (PB2)
TFT_DC: J9.6, U2.20 (PB1)
TFT_MOSI: J9.4, U2.18 (PA7)
TFT_RST: J9.5, U2.19 (PB0)
TFT_SCK: J9.3, U2.16 (PA5)

Notes on the sheet:
Right_M1
Right_F1
Left_M1
Left_F1
Bottom_F1
Screen
Bottom_M1

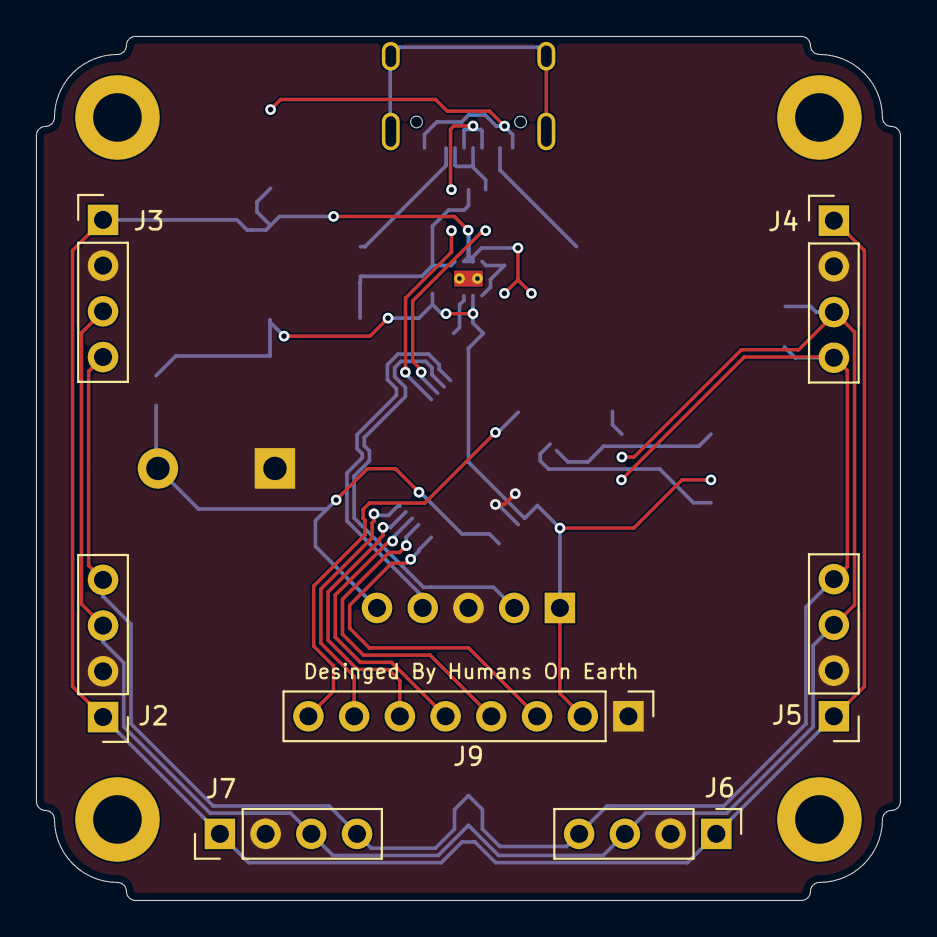
[picture p28: board hub-pcb.kicad_pcb from above]

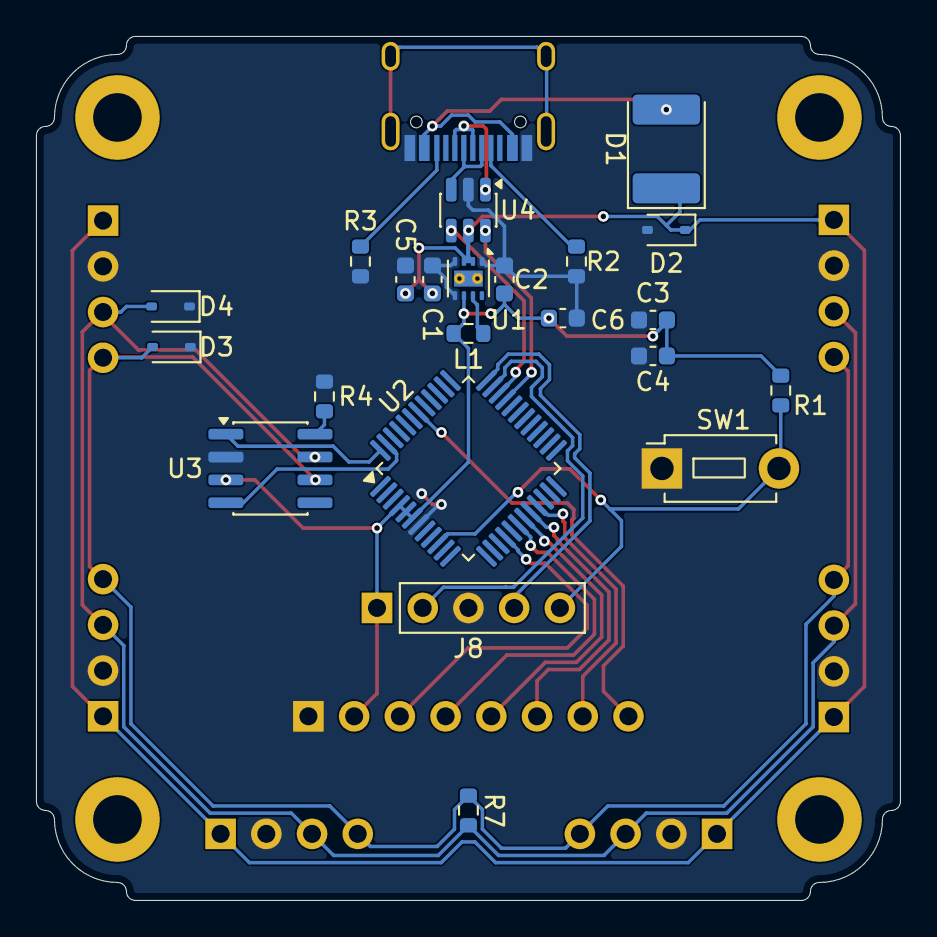
[picture p29: board hub-pcb.kicad_pcb from below]

Board: 2 copper layers, 48.0 x 48.0 mm, 30 parts (23 on the bottom side), 25 nets.
