JoelNymark/modu-hardware/screen-pcb/screen-pcb.kicad_pcb

## KiCad design screen-pcb/screen-pcb.kicad_pcb (2026-11-01)

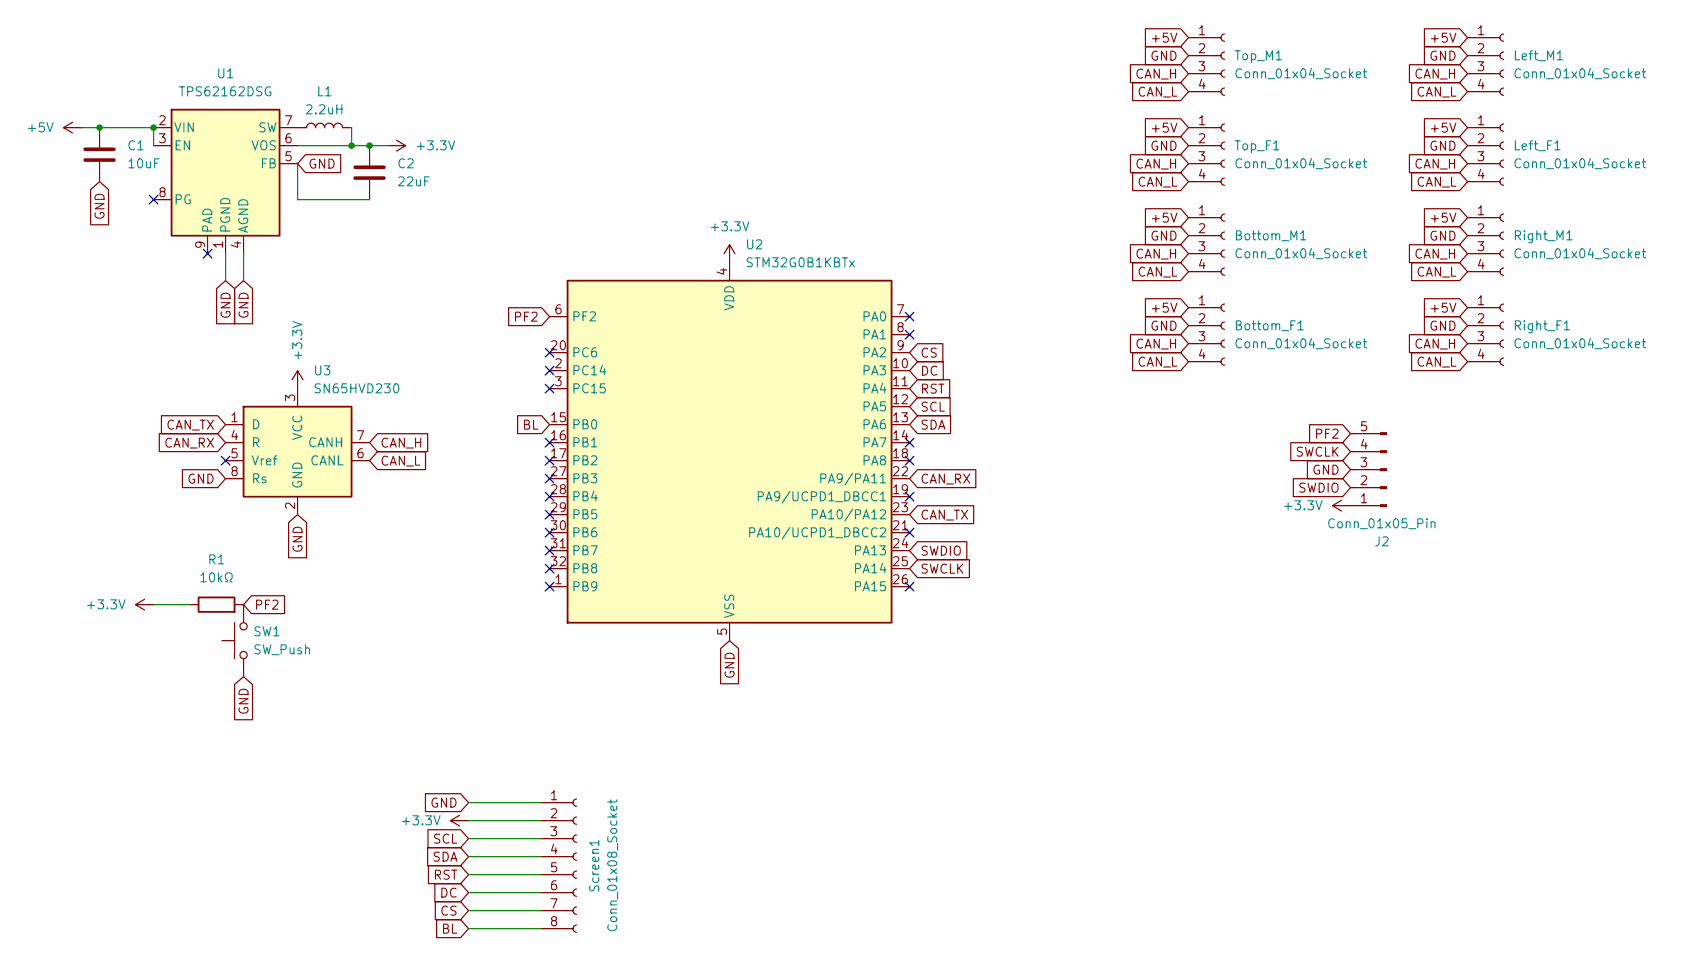
[picture p30: schematic screen-pcb.kicad_sch, Screen Module]

Parts:
Bottom_F1: Conn_01x04_Socket; PinHeader_1x04_P2.54mm_Vertical
Bottom_M1: Conn_01x04_Socket; PinHeader_1x04_P2.54mm_Vertical
C1: 10uF; C_0603_1608Metric
C2: 22uF; C_0603_1608Metric
J2: Conn_01x05_Pin; PinHeader_1x05_P2.54mm_Vertical
L1: 2.2uH; R_0603_1608Metric
Left_F1: Conn_01x04_Socket; PinHeader_1x04_P2.54mm_Vertical
Left_M1: Conn_01x04_Socket; PinHeader_1x04_P2.54mm_Vertical
R1: 10kΩ; R_0603_1608Metric
Right_F1: Conn_01x04_Socket; PinHeader_1x04_P2.54mm_Vertical
Right_M1: Conn_01x04_Socket; PinHeader_1x04_P2.54mm_Vertical
SW1: SW_Push; SW_SPST_FSMSM
Screen1: Conn_01x08_Socket; PinHeader_1x08_P2.54mm_Vertical
Top_F1: Conn_01x04_Socket; PinHeader_1x04_P2.54mm_Vertical
Top_M1: Conn_01x04_Socket; PinHeader_1x04_P2.54mm_Vertical
U1: TPS62162DSG; WSON-8-1EP_2x2mm_P0.5mm_EP0.9x1.6mm_ThermalVias
U2: STM32G0B1KBTx; LQFP-32_7x7mm_P0.8mm
U3: SN65HVD230; SOIC-8_3.9x4.9mm_P1.27mm

Connections:
+3.3V: C2.1, J2.1, L1.2, R1.1, Screen1.2, U1.6 (VOS), U2.4 (VDD), U3.3 (VCC)
+5V: Bottom_F1.1, Bottom_M1.1, C1.1, Left_F1.1, Left_M1.1, Right_F1.1, Right_M1.1, Top_F1.1, Top_M1.1, U1.2 (VIN), U1.3 (EN)
BL: Screen1.8, U2.15 (PB0)
CAN_H: Bottom_F1.3, Bottom_M1.3, Left_F1.3, Left_M1.3, Right_F1.3, Right_M1.3, Top_F1.3, Top_M1.3, U3.7 (CANH)
CAN_L: Bottom_F1.4, Bottom_M1.4, Left_F1.4, Left_M1.4, Right_F1.4, Right_M1.4, Top_F1.4, Top_M1.4, U3.6 (CANL)
CAN_RX: U2.22 (PA9/PA11), U3.4 (R)
CAN_TX: U2.23 (PA10/PA12), U3.1 (D)
CS: Screen1.7, U2.9 (PA2)
DC: Screen1.6, U2.10 (PA3)
GND: Bottom_F1.2, Bottom_M1.2, C1.2, C2.2, J2.3, Left_F1.2, Left_M1.2, Right_F1.2, Right_M1.2, SW1.1, Screen1.1, Top_F1.2, Top_M1.2, U1.1 (PGND), U1.4 (AGND), U1.5 (FB), U2.5 (VSS), U3.2 (GND), U3.8 (Rs)
unnamed: L1.1, U1.7 (SW)
PF2: J2.5, R1.2, SW1.2, U2.6 (PF2)
RST: Screen1.5, U2.11 (PA4)
SCL: Screen1.3, U2.12 (PA5)
SDA: Screen1.4, U2.13 (PA6)
SWCLK: J2.4, U2.25 (PA14)
SWDIO: J2.2, U2.24 (PA13)

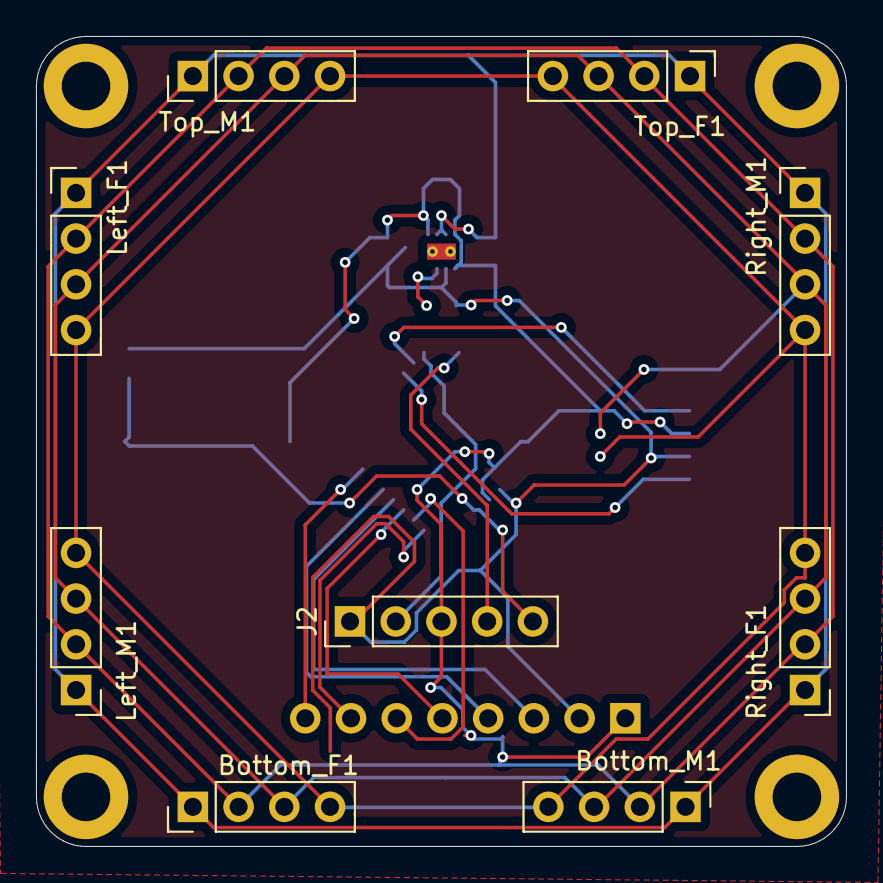
[picture p31: board screen-pcb.kicad_pcb from above]

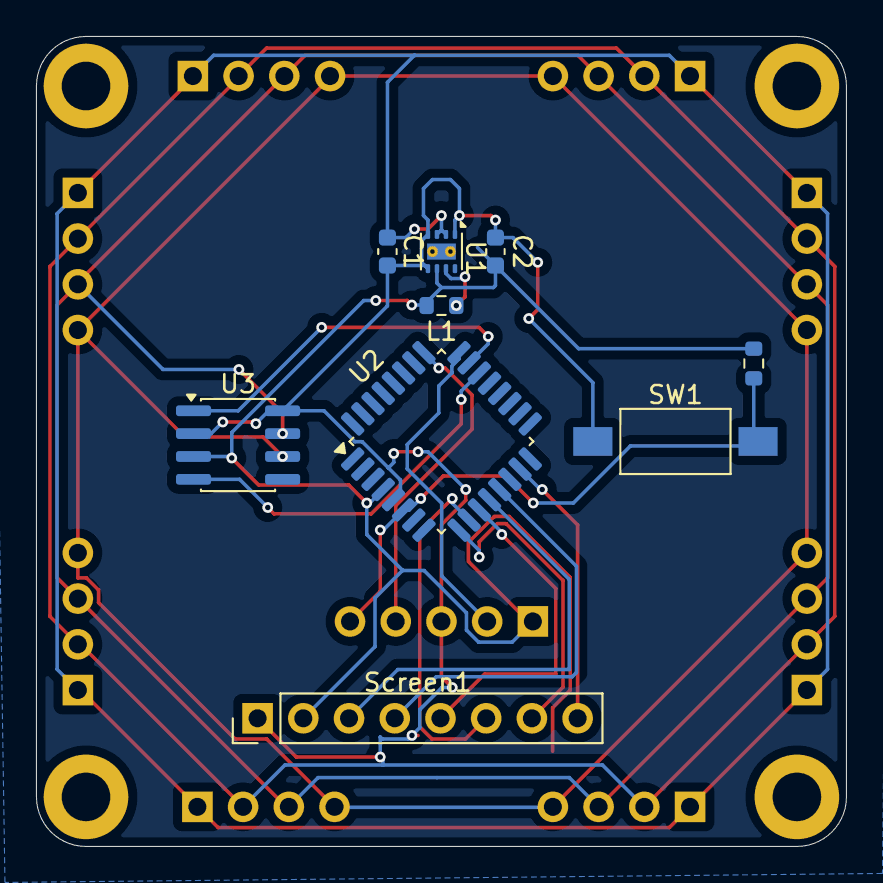
[picture p32: board screen-pcb.kicad_pcb from below]

Board: 2 copper layers, 45.0 x 45.0 mm, 18 parts (9 on the bottom side), 17 nets.
