JoelNymark/modu-hardware/(commit log)

2026-09-18 Initial commit of KiCad hardware projects
    [2x2-key-pcb.kicad_pcb, 2x2-key-pcb.kicad_sch, 4x4-key-pcb.kicad_pcb, 4x4-key-pcb.kicad_sch, 4x4-key-pcb.stl, bom.csv, designators.csv, hub-pcb.kicad_pcb]
2026-09-18 routed 4x4 pad
    [4x4-key-pcb.kicad_pcb, 4x4-key-pcb.kicad_sch]
2026-11-09 redid some wires for hub
2026-11-10 changed stuff in hub reset button and orientation of some comps
